AndrewFrelas/DS1302-Based-Chinese-4-in-1-Clock-Mod-ESP32-C3-Super-Mini-NTP-Time-Sync-Canada-Based/NtpClockMod.ino

// NtpClockMod - Andrew Frelas
// NTP-accurate time on the Temu 4-in-1 clock (YM-SZ010-L board) by answering the stock
// MCU's DS1302 reads. Single-file Arduino sketch. Reference: project doc ntp-clock-mod.md
//
// Target : ESP32-C3, Arduino IDE, Espressif "esp32" core 3.3.x, no external libraries
// Board  : "ESP32C3 Dev Module" (or the entry for your C3 board)
//          Tools > USB CDC On Boot: Enabled   (serial log over the C3's native USB)

// ============================================================================ CONFIGURATION

#define FW_VERSION              "01.05.01"

// ---- Wi-Fi (hardcoded; everything else is settable in the web UI and stored in NVS)
#define WIFI_SSID               "your-ssid"
#define WIFI_PASSWORD           "your-password"
#define DEVICE_HOSTNAME         "ntpclock"          // web UI: http://ntpclock.local/

// Reconnect policy: the device retries for as long as it is powered, forever.
#define WIFI_RETRY_MIN_MS       5000UL              // first retry delay after a drop
#define WIFI_RETRY_MAX_MS       60000UL             // retry delay ceiling
#define WIFI_RADIO_RESET_TRIES  12                  // failed tries before the radio is restarted

// Transmit power. Every converging report on the C3 SuperMini running hot points at the radio,
// not the core: a no-WiFi build stays cool, cutting TX power fixed it outright for one user,
// and a thermal camera showed 60 C -> 40 C from allowing modem sleep. Underclocking the CPU
// was tried once and changed nothing.
//
// esp_wifi_set_max_tx_power takes 0.25 dBm units, range [8, 84] = 2 to 20 dBm, and QUANTISES:
// {set, actual} = {8,8} {20,20} {28,28} {34,34} {44,44} {52,52} {56,56} {60,60} {66,66}
// {72,72} {80,80}, i.e. 2, 5, 7, 8, 11, 13, 14, 15, 16, 18, 20 dBm. Anything between rounds
// DOWN to the next step. The Arduino enum lies twice: WIFI_POWER_21dBm actually yields 20, and
// WIFI_POWER_MINUS_1dBm (-4) is outside the legal range and is refused. Neither is offered.
//
// Default 11 dBm: a 9 dB cut from the 20 dBm default, about an eighth of the transmit power.
// TX power cannot affect DS1302 bus timing, so this is the risk-free half of the heat work.
// Must be re-applied after every STA start - a radio reset puts it back to the default.
#define WIFI_TX_DBM_DEFAULT     11

// Modem sleep. This is the bigger lever by the one measurement anyone has taken, but it is
// also the one that could touch bus timing, so it stays off by default. WIFI_PS_MIN_MODEM
// parks the radio between DTIM beacons and leaves the CPU running, so the IRAM ISR should be
// unaffected - watch late_sclk_edge, over_budget and timeouts in Bus diagnostics to confirm
// rather than assuming. 0 = none, 1 = min modem, 2 = max modem.
#define WIFI_PS_MODE_DEFAULT    0

// ---- Optional web UI login. Empty user = no authentication (LAN only).
#define WEB_AUTH_USER           ""
#define WEB_AUTH_PASS           ""

// ---- Time defaults (first boot only; all four are editable in the web UI)
// One NTP server. No fallback servers are configured and DHCP-supplied NTP servers are
// rejected. Public pool servers: the NTP Pool asks for no more than 4-5 queries per hour,
// so use a local NTP server (router, NAS, pfSense) if you want minute-level polling.
#define DEFAULT_NTP_SERVER      "time.chu.nrc.ca"
#define DEFAULT_NTP_SERVER2     "time.nrc.ca"       // empty string = slot unused
#define DEFAULT_NTP_SERVER3     ""
#define NTP_SERVER_SLOTS        3

// Failover policy. lwIP's own multi-server handling is round-robin and STICKY: one 15 s
// timeout moves to the next slot and it stays there for good, so a single blip permanently
// demotes the primary. So lwIP is given exactly ONE server at a time in slot 0 and the policy
// lives in ntpPolicy(), where it can be reasoned about. With no other slot populated lwIP's
// internal index cannot move at all.
//
// A server that has not answered within NTP_PROBE_S of being selected is passed over. One that
// has answered is judged on ongoing silence instead, over NTP_FAILOVER_AFTER_MULT poll
// intervals floored at NTP_FAILOVER_MIN_S. While running on a fallback the primary is retried
// every NTP_RETURN_PRIMARY_S and keeps the slot if it answers.
//
// NTP_FAILOVER_DEFAULT false gives strict single-server operation. Runtime-settable either way.
#define NTP_FAILOVER_DEFAULT    true
#define NTP_FAILOVER_AFTER_MULT 2
#define NTP_FAILOVER_MIN_S      90UL
#define NTP_RETURN_PRIMARY_S    1800UL
#define NTP_PROBE_S             60UL

// How often ntpPolicy() is allowed to do any real work, in milliseconds.
//
// This exists because of a regression, and the reason is worth keeping. The policy reads
// syncCount() and lastSyncAgeUs(), and BOTH take portENTER_CRITICAL - which raises the
// interrupt threshold above BUS_INTR_LEVEL and masks the DS1302 CE ISR for their duration.
// loop() ends in delay(2), so it runs a few hundred times a second; without this gate the
// policy was taking roughly a thousand critical sections per second, every one of them a
// window where a CE rise could lose SCLK edges. The watchdog it replaced took ZERO in the
// steady state, because it bailed on a plain millis() comparison before touching anything.
//
// The visible cost was a dropped read now and then, which is a 5 on the face, and a minute
// flip arriving a poll cycle late because the read that would have carried the new minute was
// the one that got lost.
//
// One second against failover windows of 60 s and 90 s changes nothing that matters.
//
// The rule this encodes: anything called from loop() on this project must not take a lock on
// its common path. The bus ISR is the highest-value thing in the system and every critical
// section anywhere else is time it cannot run.
#define NTP_POLICY_PERIOD_MS    1000UL
#define DEFAULT_TZ              "EST5EDT,M3.2.0,M11.1.0"   // POSIX rule, America/Toronto
#define DEFAULT_SYNC_INTERVAL_S 60                  // NTP poll interval, seconds
#define DEFAULT_DST_MODE        0                   // 0 = follow zone rule, 1 = standard only, 2 = daylight only
#define DEFAULT_HOUR_FORMAT     0                   // 0 = follow the MCU, 1 = 24 hour, 2 = 12 hour

// Firmware-level hour format override. DEFAULT_HOUR_FORMAT above is only the FIRST-BOOT value:
// once anything is in NVS the compiled-in value is never read again, so it cannot pin the
// format on a unit that has already been configured. This one can - it outranks NVS and the
// web UI and is evaluated on every image build.
//   0 = no override, use the stored setting   1 = always 24 hour   2 = always 12 hour
// Worth knowing: "auto" learns from the MCU writing the hours register, and with the DS1302
// removed that only happens if the time is set with the clock's own buttons. On a fresh build
// there is usually nothing to learn from, so auto sits on 24 hour indefinitely.
#define HOUR_FORMAT_FORCE       0
#define DEFAULT_SPOOF_ENABLED   false               // off until the passive bus check passes
#define DEFAULT_BOOT_COUNTDOWN  true                // show 00:00, 03:00, 02:00, 01:00 on first arm

// Poll interval limits. 15 s is the floor enforced by SNTP (RFC 4330).
// Crystal drift. The estimator is two-point: NTP time elapsed against esp_timer elapsed from a
// baseline taken at the first sync. Its noise floor is 2 * jitter / span, so at a 300 s span
// with 10 ms of sync jitter the figure carries about +/- 67 ppm of uncertainty - larger than
// the tens of ppm it is measuring. The old gate declared it valid there, which is why a cold
// boot reported figures like 127 ppm. These are the spans at which it is worth quoting.
#define DRIFT_PPM_LIMIT         250.0f    // discard any estimate outside +/- this: bad data
#define DRIFT_VALID_SPAN_S      3600UL    // baseline before the figure is trusted
#define DRIFT_SYNC_JITTER_US    10000.0f  // assumed per-endpoint sync jitter, for the error bar
#define DRIFT_RECENT_MIN_SPAN_S 1800UL    // shortest window for the recent-rate diagnostic

#define NTP_MIN_INTERVAL_S      15UL
#define NTP_MAX_INTERVAL_S      86400UL

// How long the ESP32 keeps answering from its own clock after the last successful sync.
// Past this the bus goes high-Z and the real DS1302 answers. 0 = stop as soon as Wi-Fi drops.
#define NTP_HOLDOVER_HOURS      24

// Boot countdown step length, milliseconds (stretched to the MCU poll interval if slower).
#define BOOT_COUNTDOWN_STEP_MS  1000UL

// ---- DS1302 tap (doc section 5)
#define PIN_CE                  3   // DS1302 pin 5 - input only, rising-edge interrupt
#define PIN_SCLK                4   // DS1302 pin 7 - input only
#define PIN_IO                  5   // DS1302 pin 6 - high-Z except the data phase of a spoofed read

// ---- Bus engine
#define IO_DRIVE_STRENGTH       3   // PIN_IO drive capability 0..3 (3 = strongest: 40 mA source)
#define BUS_INTR_LEVEL          3   // CE ISR interrupt level 1..3 (3 = lowest entry latency)

// ---- DS1302 physically removed: full emulation
// 1 = the DS1302 is OUT and the ESP32 is the only thing that can answer the MCU. It then
// answers EVERY read, including before the first NTP sync, because an unanswered read
// leaves the MCU staring at a floating line. Clock registers come from NTP time (a fixed
// sane BCD image until the first sync), the control register reads back 80h, and RAM /
// trickle-charger reads are answered with zeros rather than left floating.
// 0 = the chip is fitted; behave as before and leave unspoofable reads to the real chip.
#define RTC_CHIP_REMOVED        1

// I/O drive style. 0 = push-pull (drives both levels at 3.3 V).
// 1 = open-drain: pull low only, let an external pull-up make the high. Use this with a
// 10k pull-up from the I/O line to 5 V if the MCU will not accept a 3.3 V logic high.
#define IO_OPEN_DRAIN           0

// First data bit of a read. 1 = present bit 0 as soon as the command byte completes (on the
// 8th rising edge) instead of waiting for the following falling edge. Some MCUs sample the
// first bit during the clock that ends the command, and with the datasheet timing they
// latch the command's own last bit and read every byte shifted one place left.
// Symptom of needing this: values come back as (real << 1) | 1.
#define IO_FIRST_BIT_EARLY      1

// ---- Outdoor temperature output (replaces the removed NTC bead)
// Topology measured on this board: 5V --[NTC]-- node --[~1k]-- GND, node at 2.0 V @ 21 C.
// With the bead removed the 1k holds the node at 0 V, so nothing can push 5 V back into this
// pin and no series resistor is needed. Drive the pad that reads 0 V with the bead out -
// NOT the pad that reads 5 V, which is the supply rail.
// Lower duty = lower node voltage = COLDER on the display.
#define TEMP_OUT_ENABLE         1       // 0 = never touch the pin
#define TEMP_OUT_PIN            7       // dead quiet in the GPIO scan; CE/SCLK/IO stay on 3/4/5

// PWM frequency ceiling. LEDC needs 2^bits timer ticks per period, so the ceiling is
// source_clock / 2^bits. The source is NOT the 80 MHz APB the ESP-IDF docs describe: the
// Arduino core sets LEDC_DEFAULT_CLK to LEDC_USE_XTAL_CLK on every chip with
// SOC_LEDC_SUPPORT_XTAL_CLOCK, which the C3 has, so it is the 40 MHz crystal. Real ceilings
// are 39.06 kHz at 10 bits, 78.125 kHz at 9, 156.25 kHz at 8. Above the ceiling
// ledc_timer_config() fails, ledcAttach() returns false, and the pin is never driven at all.
//
// 9 bits at 76 kHz: 0.49 C of ripple with 220 ohm and 2.2 uF, and 511 steps is still
// 0.13 C per step across the whole 0-40 C span. TEMP_RAW_MAX follows TEMP_PWM_BITS, but the
// calibration table is in raw units and must be re-measured if either changes.
#define TEMP_PWM_FREQ_HZ        76000
#define TEMP_PWM_BITS           9
#define TEMP_RAW_MAX            ((1 << TEMP_PWM_BITS) - 1)
#define TEMP_SWEEP_STEP_MS      15000UL   // dwell per step in the raw ripple sweep

// Tried in order until one attaches, so a bad frequency constant can never leave the output
// silently dead again. The achieved frequency is reported on serial and in the web UI.
#define TEMP_PWM_FALLBACKS      60000, 50000, 40000, 25000, 10000

// The RC that turns the PWM into a DC level, and the board's own lower divider leg. 220 ohm
// is the largest value that still reaches 40 C (full duty must clear 2.935 V) while keeping
// ripple at 0.5 C with 2.2 uF at 78 kHz. 470 ohm is quieter but caps the display at 37 C;
// 100 ohm reaches 40 C but leaves 1.05 C of ripple. These only affect the reported node
// voltage - change them to match what is actually fitted.
#define TEMP_SERIES_OHMS        220L
#define TEMP_NODE_LOWER_OHMS    2700L
#define TEMP_NODE_MV_MAX        (3300L * TEMP_NODE_LOWER_OHMS \
                                 / (TEMP_SERIES_OHMS + TEMP_NODE_LOWER_OHMS))
#define TEMP_HOLD_MS            180000UL  // "show 20 C" hold length, then it reverts
#define TEMP_MARCH_STEP_MS      20000UL   // default dwell; 12 s let a settling value be misread
#define TEMP_DWELL_MIN_S        5UL       // /api/temp dwell= bounds, in seconds
#define TEMP_DWELL_MAX_S        120UL
#define TEMP_HOLD_MIN_C         -50.0f    // accepted range for a requested temperature
#define TEMP_HOLD_MAX_C         60.0f

// Sub-zero encoding. The node cannot go below 0 V and 0 V reads 0 C, so the display has no
// way to show a negative number. Below zero the magnitude is sent instead: -8 C is driven as
// 8 C. With TEMP_NEG_BLINK the output alternates between that magnitude and 0 C, so a steady
// 8 means +8 and an 8 that drops to 0 and back means -8. Set to 0 for plain magnitude.
// The MCU's own ADC sampling rate is unknown: if the blink reads as an average instead of
// two distinct numbers, raise both periods until it steps cleanly.
// Whole-degree targeting. The face shows whole degrees, so aiming at a fractional value puts
// the target next to a boundary the MCU's own conversion decides, and a reading sitting at
// 21.9 can land either side of it depending on ripple and temperature. Aiming at a whole
// degree puts the target in the middle of the band that displays that number.
//   0 = send the exact value      1 = truncate toward zero: 21.9 -> 21, -3.7 -> -3
//   2 = round to nearest: 21.9 -> 22, -3.7 -> -4
// 1 and 2 are equally stable; the stability comes from landing on a whole number. 2 is never
// more than half a degree out where 1 can be a full degree, so if the face reads a degree low,
// try 2 before touching the offset. Applied BEFORE the calibration offset, so a sub-degree
// nudge is not thrown away by the rounding.
#define TEMP_WHOLE_DEGREES      1

// Sub-zero handling. The display has no minus sign and the MCU has no notion of a negative
// temperature, so a negative reading is sent as its MAGNITUDE and nothing else: -4 C shows as
// 4. A deliberate loss of information - the alternative was blinking between the magnitude and
// 0 C to hint at the sign, which encodes a meaning the hardware cannot express and reads as a
// fault rather than a minus sign.
//   0 = magnitude only, steady   1 = alternate between the magnitude and 0 C while below zero
#define TEMP_NEG_BLINK          0
#define TEMP_NEG_HIGH_MS        4000UL    // time showing the magnitude
#define TEMP_NEG_LOW_MS         2000UL    // time showing 0 C

// ---- Outdoor temperature feed (Environment and Climate Change Canada, SWOB-ML)
// Static per-station URL, no API key. CWWB = Burlington Pier (WMO 71437), the station ECCC's
// own Oakville page sources its current conditions from. Hourly, published about a minute past.
// Parsing: the literal "air_temp" WITH both quotes is unique in the document - the bare string
// also appears in avg_air_temp_pst1hr, max_air_temp_pst24hrs and six more. Same for "date_tm".
// Plain HTTP is UNTESTED against this host (could not be reached from the build environment).
// Leave WX_USE_HTTPS at 1 unless http:// is confirmed to return 200, not a redirect.
// TLS here is unauthenticated (no cert store on the device). The payload is public weather
// data and the worst case of a tampered reply is a wrong number on a clock face.
#define WX_ENABLE               1
#define WX_USE_HTTPS            1
#define WX_HOST                 "dd.weather.gc.ca"
#define WX_PATH_PREFIX          "/today/observations/swob-ml/latest/"
// Station file naming is not uniform: automatic stations publish as <CODE>-AUTO-swob.xml and
// staffed ones as <CODE>-MAN-swob.xml. 99 of the 871 files in the directory are MAN, so it is
// not an edge case - Pearson is CYYZ-MAN and Hamilton is CYHM-MAN, while Burlington Pier,
// Toronto City and Billy Bishop are all AUTO.
//
// A bare code probes AUTO then MAN with a HEAD request and caches the winner, so the normal
// path stays a single GET. A code containing "-" is taken verbatim as a full stem and never
// probed. A 404 retries the other suffix and re-caches only on a 200, so a station that
// changes category fixes itself and a transient outage cannot corrupt the cache.
#define WX_PATH_SUFFIX          "-AUTO-swob.xml"
#define WX_PATH_SUFFIX_ALT      "-MAN-swob.xml"
#define WX_PROBE_TIMEOUT_MS     8000
#define WX_STATION_DEFAULT      "CWWB"
#define WX_FETCH_INTERVAL_S     600UL     // observation is hourly; this just recovers misses
#define WX_RETRY_S              120UL     // after a failed attempt
#define WX_MAX_AGE_S            7200UL    // reject a reading whose date_tm is older than this
#define WX_TIMEOUT_MS           12000
#define WX_MAX_BYTES            32768UL   // hard cap on bytes scanned from one response
#define WX_MIN_LARGEST_BLOCK    50000UL   // skip the fetch below this; TLS needs contiguous heap

// Longest time the ISR busy-waits on one transfer. The length is projected from the
// command-byte clock rate; transfers projected past this are not answered or observed.
// Must stay far below the 300 ms interrupt watchdog.
#define BUS_TXN_BUDGET_US       40000UL

// Abort a transfer if CE stays high with no SCLK rising edge for this long.
#define BUS_EDGE_TIMEOUT_US     20000UL

// Bit-slip guard. SCLK's GPIO edge-status latch is cleared when each transfer ends; if it
// is already set when the CE ISR starts, SCLK rose before the ISR could watch it, so that
// transfer is observed but never answered. Set 0 only if SCLK is shared with another
// device that clocks it while CE is low (the passive check reports this).
#define BUS_SLIP_GUARD          1

// CE rises closer together than this count as one polling cycle.
#define POLL_GROUP_GAP_US       50000UL

// ============================================================================ END CONFIGURATION

#include <Arduino.h>
#include <ESPmDNS.h>
#include <HTTPClient.h>
#include <Preferences.h>
#include <WebServer.h>
#include <WiFi.h>
#include <WiFiClientSecure.h>

#include <algorithm>
#include <cmath>
#include <cstdarg>
#include <cstdint>
#include <cstdio>
#include <cstdlib>
#include <cstring>
#include <ctime>
#include <sys/time.h>

#include "driver/gpio.h"
#include "esp_attr.h"
#include "esp_intr_alloc.h"
#include "esp_sntp.h"
#include "esp_heap_caps.h"
#include "esp_system.h"
#include "esp_timer.h"
#include "esp_wifi.h"
#include "freertos/FreeRTOS.h"
#include "freertos/semphr.h"
#include "soc/gpio_reg.h"

// ================================================================ PURE LOGIC BEGIN
// Hardware-independent code. test/host_test.cpp extracts this region and runs it on a PC
// against a simulated MCU and DS1302.

#define DS_INLINE inline __attribute__((always_inline))

namespace ds1302 {

// Register indexes in the clock image (= burst order).
enum : uint8_t { REG_SEC = 0, REG_MIN, REG_HOUR, REG_DATE, REG_MONTH, REG_DAY, REG_YEAR, REG_CTRL };

// ---- Command byte (shifted LSB first): bit7 = 1, bit6 RAM/clock, bits5..1 address, bit0 read
DS_INLINE bool    cmdValid(uint8_t c)  { return (c & 0x80) != 0; }
DS_INLINE bool    cmdIsRead(uint8_t c) { return (c & 0x01) != 0; }
DS_INLINE bool    cmdIsRam(uint8_t c)  { return (c & 0x40) != 0; }
DS_INLINE uint8_t cmdAddr(uint8_t c)   { return (uint8_t)((c >> 1) & 0x1F); }
DS_INLINE bool    cmdIsBurst(uint8_t c){ return cmdAddr(c) == 0x1F; }

// Data bytes that follow a command: 1, or 8 for clock burst, 31 for RAM burst.
DS_INLINE uint8_t cmdDataBytes(uint8_t c) {
  if (!cmdIsBurst(c)) return 1;
  return cmdIsRam(c) ? 31 : 8;
}

// Reads the ESP32 answers: 81h..8Dh (seconds..year) and BFh (clock burst).
// 8Fh control, 91h trickle charger and all RAM reads stay with the real chip.
DS_INLINE bool cmdIsSpoofable(uint8_t c) {
  if ((c & 0xC1) != 0x81) return false;          // valid + clock space + read
  const uint8_t a = cmdAddr(c);
  return a <= REG_YEAR || a == 0x1F;
}

// ---- BCD
DS_INLINE uint8_t toBcd(uint8_t v)   { return (uint8_t)(((v / 10) << 4) | (v % 10)); }
DS_INLINE uint8_t fromBcd(uint8_t b) { return (uint8_t)(((b >> 4) * 10) + (b & 0x0F)); }
DS_INLINE bool    isBcd(uint8_t b)   { return (b & 0x0F) <= 9 && (b >> 4) <= 9; }

// ---- Hours register. bit7: 1 = 12 h mode (bit5 = PM, bits4..0 = 1..12), 0 = 24 h (bits5..0).
enum class HourMode : uint8_t { H24 = 0, H12 = 1 };

inline uint8_t encodeHour(int hour24, HourMode mode) {
  if (mode == HourMode::H24) return toBcd((uint8_t)hour24);
  int h12 = hour24 % 12;
  if (h12 == 0) h12 = 12;
  return (uint8_t)(0x80 | (hour24 >= 12 ? 0x20 : 0x00) | toBcd((uint8_t)h12));
}

// Returns 0..23, or -1 if the byte is not a legal hours value. (Called from the ISR.)
DS_INLINE int decodeHour(uint8_t reg) {
  if (reg & 0x80) {
    const uint8_t v = reg & 0x1F;
    if (!isBcd(v)) return -1;
    const int h = fromBcd(v);
    if (h < 1 || h > 12) return -1;
    return (h % 12) + ((reg & 0x20) ? 12 : 0);
  }
  const uint8_t v = reg & 0x3F;
  if (!isBcd(v)) return -1;
  const int h = fromBcd(v);
  return h <= 23 ? h : -1;
}

// ---- Clock image from broken-down local time. Control byte is left 0; the engine
// never drives it (burst byte 7 is released so the real chip's WP bit is read).
inline void buildImage(const std::tm& t, HourMode mode, uint8_t reg[8]) {
  reg[REG_SEC]   = toBcd((uint8_t)(t.tm_sec > 59 ? 59 : t.tm_sec));   // CH = 0; leap second clamps
  reg[REG_MIN]   = toBcd((uint8_t)t.tm_min);
  reg[REG_HOUR]  = encodeHour(t.tm_hour, mode);
  reg[REG_DATE]  = toBcd((uint8_t)t.tm_mday);
  reg[REG_MONTH] = toBcd((uint8_t)(t.tm_mon + 1));
  reg[REG_DAY]   = (uint8_t)(t.tm_wday + 1);                            // 1..7, Sunday = 1
  reg[REG_YEAR]  = toBcd((uint8_t)(t.tm_year % 100));
  reg[REG_CTRL]  = 0x00;
}

// True if the seven clock bytes are plausible BCD time.
inline bool imageLooksValid(const uint8_t reg[7]) {
  const uint8_t sec = reg[REG_SEC] & 0x7F;
  if (!isBcd(sec) || fromBcd(sec) > 59) return false;
  if (!isBcd(reg[REG_MIN]) || fromBcd(reg[REG_MIN]) > 59) return false;
  if (decodeHour(reg[REG_HOUR]) < 0) return false;
  if (!isBcd(reg[REG_DATE]) || fromBcd(reg[REG_DATE]) < 1 || fromBcd(reg[REG_DATE]) > 31) return false;
  if (!isBcd(reg[REG_MONTH]) || fromBcd(reg[REG_MONTH]) < 1 || fromBcd(reg[REG_MONTH]) > 12) return false;
  if (reg[REG_DAY] < 1 || reg[REG_DAY] > 7) return false;
  return isBcd(reg[REG_YEAR]);
}

// "13:05:09 2026-09-11 d6 24h" (+ " CH" if the clock-halt bit is set)
inline void formatImage(const uint8_t reg[7], char* buf, size_t n) {
  const int hour = decodeHour(reg[REG_HOUR]);
  std::snprintf(buf, n, "%02d:%02X:%02X 20%02X-%02X-%02X d%u %s%s",
                hour, reg[REG_MIN], reg[REG_SEC] & 0x7F, reg[REG_YEAR], reg[REG_MONTH],
                reg[REG_DATE], reg[REG_DAY], (reg[REG_HOUR] & 0x80) ? "12h" : "24h",
                (reg[REG_SEC] & 0x80) ? " CH" : "");
}

// "0xBF read clock burst", "0x8E write control", "0xC3 read RAM 1", "0x40 invalid (bit7=0)"
inline void describeCmd(uint8_t c, char* buf, size_t n) {
  if (!cmdValid(c)) { std::snprintf(buf, n, "0x%02X invalid (bit7=0)", c); return; }
  const char* rw = cmdIsRead(c) ? "read" : "write";
  const uint8_t a = cmdAddr(c);
  if (cmdIsRam(c)) {
    if (a == 0x1F) std::snprintf(buf, n, "0x%02X %s RAM burst", c, rw);
    else           std::snprintf(buf, n, "0x%02X %s RAM %u", c, rw, a);
    return;
  }
  static const char* const names[] = { "seconds", "minutes", "hours", "date", "month",
                                       "day", "year", "control", "trickle" };
  if (a == 0x1F)      std::snprintf(buf, n, "0x%02X %s clock burst", c, rw);
  else if (a <= 8)    std::snprintf(buf, n, "0x%02X %s %s", c, rw, names[a]);
  else                std::snprintf(buf, n, "0x%02X %s clock reg %u (undefined)", c, rw, a);
}

}  // namespace ds1302

namespace ds1302 {

enum : uint16_t {
  TF_CE_GLITCH  = 1u << 0,   // CE already low when the ISR ran
  TF_MISALIGNED = 1u << 1,   // SCLK high at entry: ISR ran late (or MCU broke tCC)
  TF_CMD        = 1u << 2,   // all 8 command bits received
  TF_INVALID    = 1u << 3,   // command bit7 = 0
  TF_READ       = 1u << 4,
  TF_BURST      = 1u << 5,
  TF_RAM        = 1u << 6,
  TF_SPOOFED    = 1u << 7,   // ESP32 answered the data phase
  TF_TOO_SLOW   = 1u << 8,   // projected length over the ISR budget: not touched
  TF_LONG       = 1u << 9,   // RAM burst (31 bytes): not touched
  TF_TIMEOUT    = 1u << 10,  // aborted mid-transaction (edge timeout / budget)
  TF_COMPLETE   = 1u << 11,  // every expected data bit was clocked
  TF_LATE_EDGE  = 1u << 12,  // SCLK rose before the ISR started: observed, never answered
};

struct TxnRecord {
  int64_t  t0Us;       // ISR entry (esp_timer time)
  uint32_t durUs;      // ISR entry -> exit
  uint32_t spanUs;     // first -> last SCLK rising edge
  uint16_t flags;
  uint16_t rises;      // SCLK rising edges seen
  uint16_t dataBits;   // data bits presented (read) / latched (write)
  uint8_t  cmd;
  uint8_t  data[8];    // passive read: real chip bytes; write: MCU bytes; spoof: bytes sent
};

struct BusPins { uint32_t ce, sclk, io; };   // bit masks within GPIO_IN_REG

class BusMachine {
 public:
  static constexpr uint8_t A_DRIVE   = 0x01;  // enable output at level A_HIGH ? 1 : 0
  static constexpr uint8_t A_HIGH    = 0x02;
  static constexpr uint8_t A_RELEASE = 0x04;  // output off (high-Z)
  static constexpr uint8_t A_DONE    = 0x08;  // stop sampling, leave the ISR

  // Call once with the first sample taken in the ISR. `img` = 8-byte clock image.
  // lateEdge = SCLK rose between the previous transfer and this ISR (possible bit slip).
  DS_INLINE uint8_t begin(const BusPins& pins, uint32_t in, int64_t t0Us, const uint8_t* img,
                          const uint8_t* ram, bool armed, uint32_t budgetUs,
                          uint32_t edgeTimeoutUs, bool lateEdge) {
    p_ = pins;
    ram_ = ram;
    t0_ = t0Us; tFirst_ = t0Us; tLast_ = t0Us;
    budget_ = budgetUs; edgeTimeout_ = edgeTimeoutUs;
    armed_ = armed;
    for (uint8_t i = 0; i < 8; ++i) { img_[i] = img[i]; rec_.data[i] = 0; }
    rec_.t0Us = t0Us; rec_.durUs = 0; rec_.spanUs = 0;
    rec_.flags = 0; rec_.rises = 0; rec_.dataBits = 0; rec_.cmd = 0;
    phase_ = PH_CMD; bits_ = 0; cmd_ = 0; nBytes_ = 0;
    outIdx_ = 0; capBits_ = 0; wIdx_ = 0; srcByte_ = 0;
    spoof_ = false; burst_ = false; driving_ = false;
    prev_ = in;
    lowIo_ = in & p_.io;
    if (lateEdge)       { rec_.flags |= TF_LATE_EDGE;  armed_ = false; }
    if (!(in & p_.ce))  { rec_.flags |= TF_CE_GLITCH;  return A_DONE; }
    if (in & p_.sclk)   { rec_.flags |= TF_MISALIGNED; return A_DONE; }
    return 0;
  }

  // True if this sample is an SCLK rising edge (caller timestamps those only).
  DS_INLINE bool isRise(uint32_t in) const { return ((in ^ prev_) & in & p_.sclk) != 0; }

  // Feed one GPIO sample. `nowUs` is only read on SCLK rising edges.
  DS_INLINE uint8_t step(uint32_t in, int64_t nowUs) {
    if (!(in & p_.ce)) return endOfTransfer();
    if (!((in ^ prev_) & p_.sclk)) {                 // no clock edge
      if (!(in & p_.sclk)) lowIo_ = in & p_.io;
      return 0;
    }
    prev_ = in;
    if (in & p_.sclk) return onRise(in, nowUs);
    lowIo_ = in & p_.io;
    return onFall();
  }

  // Call periodically from the sampling loop.
  DS_INLINE uint8_t checkTimeout(int64_t nowUs) {
    const int64_t ref = rec_.rises ? tLast_ : t0_;
    if ((nowUs - t0_) > (int64_t)budget_ || (nowUs - ref) > (int64_t)edgeTimeout_) {
      rec_.flags |= TF_TIMEOUT;
      driving_ = false;
      return A_DONE | A_RELEASE;
    }
    return 0;
  }

  DS_INLINE const TxnRecord& finish(int64_t tEndUs) {
    rec_.durUs = (uint32_t)(tEndUs - t0_);
    rec_.spanUs = (uint32_t)(tLast_ - tFirst_);
    if (phase_ == PH_READ) {
      rec_.dataBits = spoof_ ? outIdx_ : capBits_;
      if (outIdx_ >= 8u * nBytes_) rec_.flags |= TF_COMPLETE;
    } else if (phase_ == PH_WRITE) {
      rec_.dataBits = wIdx_;
      if (wIdx_ >= 8u * nBytes_) rec_.flags |= TF_COMPLETE;
    }
    return rec_;
  }

  DS_INLINE bool driving() const { return driving_; }

 private:
  enum : uint8_t { PH_CMD, PH_READ, PH_WRITE };

  DS_INLINE uint8_t onRise(uint32_t in, int64_t nowUs) {
    if (rec_.rises == 0) tFirst_ = nowUs;
    tLast_ = nowUs;
    ++rec_.rises;

    if (phase_ == PH_CMD) {
      if (in & p_.io) cmd_ |= (uint8_t)(1u << bits_);
      if (++bits_ == 8) return decide();
      return 0;
    }
    if (phase_ == PH_READ) {
      // Passive: the bit the chip presented during the low phase that just ended.
      if (!spoof_ && outIdx_ > capBits_ && outIdx_ <= 64) capture(outIdx_);
      return 0;
    }
    // PH_WRITE: MCU data is latched on the rising edge, like the chip does.
    if (wIdx_ < 8u * nBytes_) {
      if (in & p_.io) rec_.data[wIdx_ >> 3] |= (uint8_t)(1u << (wIdx_ & 7));
      ++wIdx_;
    }
    return 0;
  }

  DS_INLINE uint8_t onFall() {
    if (phase_ != PH_READ) return 0;
    const uint16_t n = outIdx_++;
    if (!spoof_) return 0;
    if (burst_) {
      if (ramBurst_) return drive(0);                // RAM burst: zeros, never floating
      if (n < 56) return drive((img_[n >> 3] >> (n & 7)) & 1u);
#if RTC_CHIP_REMOVED
      if (n < 64) return drive((img_[7] >> (n & 7)) & 1u);   // byte 7 (WP): emulate it too
#endif
      return release();                              // byte 7 (WP) and beyond: real chip
    }
    return drive((outByte_ >> (n & 7)) & 1u);        // single read: repeat the byte
  }

  DS_INLINE uint8_t decide() {
    rec_.cmd = cmd_;
    rec_.flags |= TF_CMD;
    if (!cmdValid(cmd_)) { rec_.flags |= TF_INVALID; return A_DONE; }
    const bool rd = cmdIsRead(cmd_);
    burst_ = cmdIsBurst(cmd_);
    if (rd) rec_.flags |= TF_READ;
    if (burst_) rec_.flags |= TF_BURST;
    if (cmdIsRam(cmd_)) rec_.flags |= TF_RAM;
    nBytes_ = cmdDataBytes(cmd_);
    if (nBytes_ > 8) { rec_.flags |= TF_LONG; return A_DONE; }

    // Project the remaining length from the command-phase clock rate.
    const uint32_t period  = (uint32_t)(tLast_ - tFirst_) / 7u;
    const uint32_t elapsed = (uint32_t)(tLast_ - t0_);
    if (elapsed + period * (8u * nBytes_ + 2u) > budget_) { rec_.flags |= TF_TOO_SLOW; return A_DONE; }

    phase_ = rd ? PH_READ : PH_WRITE;
    ramBurst_ = burst_ && cmdIsRam(cmd_);
#if RTC_CHIP_REMOVED
    spoof_ = rd;                 // nothing else is on the bus: every read must be answered
#else
    spoof_ = rd && armed_ && cmdIsSpoofable(cmd_);
#endif
    if (spoof_) {
      rec_.flags |= TF_SPOOFED;
      const uint8_t a = cmdAddr(cmd_);
      srcByte_ = burst_ ? 0 : a;
      // Single read: clock space 0..7 comes from the image, anything else answers zeros.
      outByte_ = cmdIsRam(cmd_) ? ((ram_ && a < 31) ? ram_[a] : 0x00)
                                : ((a <= 7) ? img_[a] : 0x00);
      if (burst_) { for (uint8_t i = 0; i < 7; ++i) rec_.data[i] = ramBurst_ ? 0 : img_[i]; }
      else        { rec_.data[0] = outByte_; }
#if IO_FIRST_BIT_EARLY
      // Present bit 0 now; the falling edges below carry bits 1..7.
      outIdx_ = 1;
      return drive(burst_ ? ((ramBurst_ ? 0u : (uint32_t)img_[0]) & 1u)
                          : ((uint32_t)outByte_ & 1u));
#endif
    }
    return 0;
  }

  DS_INLINE uint8_t endOfTransfer() {
    // Last read bit may never get a following rising edge (MCU samples, then drops CE).
    if (phase_ == PH_READ && !spoof_ && outIdx_ > capBits_ && outIdx_ <= 64) capture(outIdx_);
    const uint8_t a = A_DONE | (driving_ ? A_RELEASE : 0);
    driving_ = false;
    return a;
  }

  DS_INLINE void capture(uint16_t presented) {
    const uint16_t idx = (uint16_t)(presented - 1);
    if (lowIo_) rec_.data[idx >> 3] |= (uint8_t)(1u << (idx & 7));
    capBits_ = presented;
  }

  DS_INLINE uint8_t drive(uint32_t level) { driving_ = true; return (uint8_t)(A_DRIVE | (level ? A_HIGH : 0)); }
  DS_INLINE uint8_t release() {
    if (!driving_) return 0;
    driving_ = false;
    return A_RELEASE;
  }

  BusPins   p_{};
  TxnRecord rec_{};
  int64_t   t0_ = 0, tFirst_ = 0, tLast_ = 0;
  uint32_t  budget_ = 0, edgeTimeout_ = 0;
  uint32_t  prev_ = 0, lowIo_ = 0;
  uint16_t  outIdx_ = 0, capBits_ = 0, wIdx_ = 0;
  uint8_t   img_[8]{};
  uint8_t   phase_ = PH_CMD, bits_ = 0, cmd_ = 0, nBytes_ = 0, srcByte_ = 0;
  bool      armed_ = false, spoof_ = false, burst_ = false, driving_ = false;
  uint8_t   outByte_ = 0;          // byte repeated for a single-register read
  const uint8_t* ram_ = nullptr;   // emulated DS1302 RAM, 31 bytes
  bool      ramBurst_ = false;     // RAM burst: answered with zeros
};

}  // namespace ds1302

// ---------------------------------------------------------------- POSIX TZ rule handling
//
// POSIX form: stdoffset[dst[offset][,start[/time],end[/time]]]
// Offsets are the value added to local time to get UTC, so North America is positive.
// A name is either three or more letters or a quoted form such as <+0530> or <-07>.
//
// DST mode 1 strips the daylight half of the rule (standard time all year); mode 2 keeps
// the daylight offset all year (what a province that abolishes the change would use).

namespace tzrule {

struct Parts {
  char stdName[16];
  char dstName[16];
  long stdOffset;     // seconds
  long dstOffset;     // seconds
  bool hasDst;
};

inline const char* parseName(const char* s, char* out, size_t n) {
  size_t len = 0;
  if (*s == '<') {
    ++s;
    while (*s && *s != '>' && len + 1 < n) {
      const char c = *s;
      const bool ok = (c >= '0' && c <= '9') || (c >= 'A' && c <= 'Z') || (c >= 'a' && c <= 'z') || c == '+' || c == '-';
      if (!ok) return nullptr;
      out[len++] = *s++;
    }
    if (*s != '>') return nullptr;
    ++s;
  } else {
    while (((*s >= 'A' && *s <= 'Z') || (*s >= 'a' && *s <= 'z')) && len + 1 < n) out[len++] = *s++;
  }
  if (len < 1) return nullptr;
  out[len] = '\0';
  return s;
}

// Offsets: [+|-]hh[:mm[:ss]]
inline const char* parseOffset(const char* s, long& secs, bool& present) {
  present = false;
  int sign = 1;
  if (*s == '+') { ++s; }
  else if (*s == '-') { sign = -1; ++s; }
  if (*s < '0' || *s > '9') return s;               // no offset here
  long v[3] = { 0, 0, 0 };
  for (int field = 0; field < 3; ++field) {
    long acc = 0;
    int digits = 0;
    while (*s >= '0' && *s <= '9' && digits < 3) { acc = acc * 10 + (*s++ - '0'); ++digits; }
    if (digits == 0) return nullptr;
    v[field] = acc;
    if (*s != ':') break;
    ++s;
  }
  if (v[0] > 24 || v[1] > 59 || v[2] > 59) return nullptr;
  secs = sign * (v[0] * 3600 + v[1] * 60 + v[2]);
  present = true;
  return s;
}

inline bool parse(const char* tz, Parts& p) {
  if (!tz || !*tz) return false;
  std::memset(&p, 0, sizeof p);
  const char* s = parseName(tz, p.stdName, sizeof p.stdName);
  if (!s) return false;
  bool present = false;
  s = parseOffset(s, p.stdOffset, present);
  if (!s || !present) return false;
  if (*s == '\0' || *s == ',') return true;         // no daylight half
  s = parseName(s, p.dstName, sizeof p.dstName);
  if (!s) return false;
  p.hasDst = true;
  p.dstOffset = p.stdOffset - 3600;                 // POSIX default: one hour ahead
  s = parseOffset(s, p.dstOffset, present);
  return s != nullptr;
}

inline void formatOffset(long secs, char* out, size_t n) {
  const long a = secs < 0 ? -secs : secs;
  const int h = (int)(a / 3600), m = (int)((a % 3600) / 60), sec = (int)(a % 60);
  const char* sign = secs < 0 ? "-" : "";
  if (sec) std::snprintf(out, n, "%s%d:%02d:%02d", sign, h, m, sec);
  else if (m) std::snprintf(out, n, "%s%d:%02d", sign, h, m);
  else std::snprintf(out, n, "%s%d", sign, h);
}

inline void formatName(const char* name, char* out, size_t n) {
  bool plain = std::strlen(name) >= 3;
  for (const char* c = name; *c && plain; ++c)
    if (!((*c >= 'A' && *c <= 'Z') || (*c >= 'a' && *c <= 'z'))) plain = false;
  if (plain) std::snprintf(out, n, "%s", name);
  else std::snprintf(out, n, "<%s>", name);
}

// mode 0 = rule unchanged, 1 = standard offset all year, 2 = daylight offset all year.
// Returns false and copies the input unchanged when the rule cannot be parsed.
inline bool applyMode(const char* tz, uint8_t mode, char* out, size_t n) {
  if (n == 0) return false;
  const char* src = tz ? tz : "";
  size_t i = 0;
  for (; src[i] && i + 1 < n; ++i) out[i] = src[i];
  out[i] = '\0';
  if (mode == 0) return true;
  Parts p;
  if (!parse(tz, p)) return false;
  const bool wantDst = (mode == 2) && p.hasDst;
  char name[20], off[16];
  formatName(wantDst ? p.dstName : p.stdName, name, sizeof name);
  formatOffset(wantDst ? p.dstOffset : p.stdOffset, off, sizeof off);
  std::snprintf(out, n, "%s%s", name, off);
  return true;
}

// "follows the zone rule", "standard time all year", "daylight time all year"
inline const char* modeName(uint8_t mode) {
  if (mode == 1) return "standard time all year";
  if (mode == 2) return "daylight time all year";
  return "follows the zone rule";
}

}  // namespace tzrule

// ================================================================ PURE LOGIC END

struct BusCounters {
  uint32_t ceRises;       // CE rising-edge interrupts
  uint32_t glitches;      // CE already low when the ISR ran
  uint32_t misaligned;    // SCLK high at ISR entry
  uint32_t lateEdge;      // SCLK rose before the ISR started (not answered)
  uint32_t invalid;       // command bit7 = 0
  uint32_t singleReads;   // valid read commands, one register
  uint32_t burstReads;    // valid read commands, burst
  uint32_t writes;        // valid write commands
  uint32_t spoofed;       // reads answered by the ESP32
  uint32_t passReads;     // complete clock reads answered by the real chip (captured)
  uint32_t tooSlow;       // skipped: projected length over the ISR budget
  uint32_t longTxn;       // skipped: RAM burst
  uint32_t timeouts;      // aborted mid-transaction
  uint32_t incomplete;    // CE dropped before all data bits were clocked
  uint32_t spanUsSum;     // sum of first->last SCLK rising edge spans
  uint32_t spanPeriods;   // sum of (rising edges - 1)
};

struct BusSnapshot {
  BusCounters c;
  ds1302::TxnRecord last;       // last transaction with a full command byte
  ds1302::TxnRecord lastRead;
  ds1302::TxnRecord lastWrite;
  uint8_t  real[7];             // real DS1302 clock bytes captured from passive reads
  uint8_t  realMask;            // bit n set = real[n] captured
  int64_t  realUs;              // esp_timer time of the latest capture
  int64_t  lastCeUs;            // esp_timer time of the latest CE rise
  uint32_t pollGapUs;           // latest gap between polling cycles
  int8_t   learnedHour;         // -1 unknown, 0 = MCU uses 24 h, 1 = MCU uses 12 h
  uint32_t cmdSeen[8];          // 256-bit set of command bytes decoded
};

namespace bus {

// Configure pins and install the ISR. Returns false if the ISR could not be installed.
bool begin();

// True once the CE interrupt is live.
bool isrInstalled();

// True if the GPIO ISR service was installed IRAM-safe by this module.
bool isrIramSafe();

// Hour format the MCU was seen using: -1 unknown, 0 = 24 h, 1 = 12 h.
int8_t learnedHour();

// Latest gap between polling cycles, microseconds (0 = not seen yet).
uint32_t pollGapUs();

// Hand a new 8-byte clock image to the ISR. armed = ISR may answer clock reads.
void setImage(const uint8_t reg[8], bool armed);

// Consistent copy of all diagnostics.
void snapshot(BusSnapshot& out);

// Reset the command-seen set (used by the passive bus check).
void clearCmdSeen();

}  // namespace bus

// ---------------------------------------------------------------- implementation

namespace bus {
namespace impl {

using namespace ds1302;

struct Shared {
  volatile uint32_t seq;   // seqlock: odd while the ISR is publishing
  BusCounters c;
  TxnRecord last, lastRead, lastWrite;
  uint8_t  real[7];
  uint8_t  realMask;
  int64_t  realUs;
  int64_t  lastCeUs;
  uint32_t pollGapUs;
  int8_t   learnedHour;
  uint32_t cmdSeen[8];
};

struct ImageSlot { uint8_t reg[8]; };

Shared            s_sh;
ImageSlot         s_img[2];
volatile uint8_t  s_imgActive = 0;     // written only by setImage()
DRAM_ATTR uint8_t s_ram[31] = {0};     // emulated DS1302 scratch RAM (chip-removed mode)
volatile bool     s_armed = false;
bool              s_iramSafe = false;
bool              s_installed = false;
BusMachine        s_machine;           // single instance: the ISR is not re-entrant

DRAM_ATTR const BusPins s_pins = { 1UL << PIN_CE, 1UL << PIN_SCLK, 1UL << PIN_IO };

constexpr uint32_t IO_MASK = 1UL << PIN_IO;
constexpr uint32_t SCLK_MASK = 1UL << PIN_SCLK;

int levelFlag() {
#if BUS_INTR_LEVEL == 1
  return ESP_INTR_FLAG_LEVEL1;
#elif BUS_INTR_LEVEL == 2
  return ESP_INTR_FLAG_LEVEL2;
#else
  return ESP_INTR_FLAG_LEVEL3;
#endif
}

inline __attribute__((always_inline)) void learnHour(Shared& s, uint8_t reg) {
  if (decodeHour(reg) >= 0) s.learnedHour = (reg & 0x80) ? 1 : 0;
}

IRAM_ATTR void publish(const TxnRecord& r) {
  Shared& s = s_sh;
  s.seq = s.seq + 1;
  BusCounters& c = s.c;
  const uint16_t f = r.flags;

  ++c.ceRises;
  if (s.lastCeUs != 0 && (r.t0Us - s.lastCeUs) > (int64_t)POLL_GROUP_GAP_US)
    s.pollGapUs = (uint32_t)(r.t0Us - s.lastCeUs);
  s.lastCeUs = r.t0Us;

  if (f & TF_CE_GLITCH)  ++c.glitches;
  if (f & TF_MISALIGNED) ++c.misaligned;
  if (f & TF_LATE_EDGE)  ++c.lateEdge;
  if (f & TF_TIMEOUT)    ++c.timeouts;
  if (f & TF_TOO_SLOW)   ++c.tooSlow;
  if (f & TF_LONG)       ++c.longTxn;
  if (r.rises >= 2) { c.spanUsSum += r.spanUs; c.spanPeriods += (uint32_t)(r.rises - 1); }

  if (f & TF_CMD) {
    s.cmdSeen[r.cmd >> 5] |= 1UL << (r.cmd & 31);
    s.last = r;
    if (f & TF_INVALID) {
      ++c.invalid;
    } else {
      const bool handled = !(f & (TF_TOO_SLOW | TF_LONG | TF_TIMEOUT | TF_LATE_EDGE));
      const bool clock   = !(f & TF_RAM);
      const bool burst   = (f & TF_BURST) != 0;
      const uint8_t addr = cmdAddr(r.cmd);
      if (handled && !(f & TF_COMPLETE)) ++c.incomplete;

      // Store single-byte RAM writes. The MCU keeps its own state in the DS1302's RAM and
      // must read back what it wrote; answering zeros silently corrupts it.
      if (handled && !clock && !burst && !(f & TF_READ) && (f & TF_COMPLETE) && addr < 31)
        s_ram[addr] = r.data[0];

      if (f & TF_READ) {
        if (burst) ++c.burstReads; else ++c.singleReads;
        s.lastRead = r;
        if (f & TF_SPOOFED) {
          ++c.spoofed;
        } else if (handled && clock) {
          if (burst && r.dataBits >= 56) {              // 7 clock bytes captured
            for (uint8_t i = 0; i < 7; ++i) s.real[i] = r.data[i];
            s.realMask = 0x7F;
            s.realUs = r.t0Us;
            learnHour(s, r.data[REG_HOUR]);
            ++c.passReads;
          } else if (!burst && addr <= REG_YEAR && r.dataBits >= 8) {
            s.real[addr] = r.data[0];
            s.realMask |= (uint8_t)(1u << addr);
            s.realUs = r.t0Us;
            if (addr == REG_HOUR) learnHour(s, r.data[0]);
            ++c.passReads;
          }
        }
      } else {
        ++c.writes;
        s.lastWrite = r;
        if (handled && clock) {
          if (burst && r.dataBits >= 24) learnHour(s, r.data[REG_HOUR]);
          else if (!burst && addr == REG_HOUR && r.dataBits >= 8) learnHour(s, r.data[0]);
        }
      }
    }
  }
  s.seq = s.seq + 1;
}

// CE rising edge: follow the whole transaction by polling, then return.
IRAM_ATTR void ceRiseIsr(void*) {
  const int64_t t0 = esp_timer_get_time();
  uint32_t in = REG_READ(GPIO_IN_REG);
#if BUS_SLIP_GUARD
  const bool lateEdge = (REG_READ(GPIO_STATUS_REG) & SCLK_MASK) != 0;
#else
  const bool lateEdge = false;
#endif
  BusMachine& m = s_machine;
  uint8_t a = m.begin(s_pins, in, t0, s_img[s_imgActive].reg, s_ram, s_armed,
                      BUS_TXN_BUDGET_US, BUS_EDGE_TIMEOUT_US, lateEdge);
  bool outOn = false;
  uint32_t spins = 0;

  while (!(a & BusMachine::A_DONE)) {
    in = REG_READ(GPIO_IN_REG);
    a = m.step(in, m.isRise(in) ? esp_timer_get_time() : 0);
    if (a & BusMachine::A_DRIVE) {
      // Level first, then output enable: no glitch on the first driven bit.
#if IO_OPEN_DRAIN
      if (a & BusMachine::A_HIGH) {                  // high = let the external pull-up do it
        if (outOn) { REG_WRITE(GPIO_ENABLE_W1TC_REG, IO_MASK); outOn = false; }
      } else {
        REG_WRITE(GPIO_OUT_W1TC_REG, IO_MASK);
        if (!outOn) { REG_WRITE(GPIO_ENABLE_W1TS_REG, IO_MASK); outOn = true; }
      }
#else
      REG_WRITE((a & BusMachine::A_HIGH) ? GPIO_OUT_W1TS_REG : GPIO_OUT_W1TC_REG, IO_MASK);
      if (!outOn) { REG_WRITE(GPIO_ENABLE_W1TS_REG, IO_MASK); outOn = true; }
#endif
    } else if (a & BusMachine::A_RELEASE) {
      REG_WRITE(GPIO_ENABLE_W1TC_REG, IO_MASK);
      outOn = false;
    }
    if ((++spins & 0x3FF) == 0 && !(a & BusMachine::A_DONE))
      a |= m.checkTimeout(esp_timer_get_time());
  }

  REG_WRITE(GPIO_ENABLE_W1TC_REG, IO_MASK);   // always leave the ISR high-Z
  REG_WRITE(GPIO_STATUS_W1TC_REG, SCLK_MASK); // arm the slip latch for the next transfer
  publish(m.finish(esp_timer_get_time()));
}

}  // namespace impl

using namespace impl;

bool begin() {
  s_sh.learnedHour = -1;

  // CE + SCLK: plain inputs, no pulls (the DS1302 has 40k pulldowns, the MCU drives both).
  gpio_config_t cfg = {};
  cfg.pin_bit_mask = (1ULL << PIN_CE) | (1ULL << PIN_SCLK);
  cfg.mode = GPIO_MODE_INPUT;
  cfg.pull_up_en = GPIO_PULLUP_DISABLE;
  cfg.pull_down_en = GPIO_PULLDOWN_DISABLE;
  cfg.intr_type = GPIO_INTR_DISABLE;
  if (gpio_config(&cfg) != ESP_OK) return false;

  // I/O: input always on; the ISR toggles output enable. Output latch preset low.
  gpio_set_level((gpio_num_t)PIN_IO, 0);
  cfg.pin_bit_mask = 1ULL << PIN_IO;
  cfg.mode = GPIO_MODE_INPUT_OUTPUT;
  if (gpio_config(&cfg) != ESP_OK) return false;
  REG_WRITE(GPIO_ENABLE_W1TC_REG, IO_MASK);   // high-Z
  gpio_set_drive_capability((gpio_num_t)PIN_IO, (gpio_drive_cap_t)IO_DRIVE_STRENGTH);

  const esp_err_t err = gpio_install_isr_service(ESP_INTR_FLAG_IRAM | levelFlag());
  if (err == ESP_OK) s_iramSafe = true;
  else if (err != ESP_ERR_INVALID_STATE) return false;   // INVALID_STATE: installed elsewhere

  // SCLK: rising-edge status latch only. Its interrupt stays disabled, so the GPIO ISR
  // service never dispatches it (it only sees status & enable); the CE ISR reads and
  // clears the raw bit itself.
  if (gpio_set_intr_type((gpio_num_t)PIN_SCLK, GPIO_INTR_POSEDGE) != ESP_OK) return false;
  gpio_intr_disable((gpio_num_t)PIN_SCLK);
  REG_WRITE(GPIO_STATUS_W1TC_REG, SCLK_MASK);

  if (gpio_set_intr_type((gpio_num_t)PIN_CE, GPIO_INTR_POSEDGE) != ESP_OK) return false;
  if (gpio_isr_handler_add((gpio_num_t)PIN_CE, ceRiseIsr, nullptr) != ESP_OK) return false;
  s_installed = gpio_intr_enable((gpio_num_t)PIN_CE) == ESP_OK;
  return s_installed;
}

bool isrInstalled() { return s_installed; }

bool isrIramSafe() { return s_iramSafe; }

int8_t learnedHour() { return s_sh.learnedHour; }

uint32_t pollGapUs() { return s_sh.pollGapUs; }

// Single writer (the time task). The ISR only ever reads the active slot.
void setImage(const uint8_t reg[8], bool armed) {
  if (!armed) s_armed = false;
  const uint8_t next = (uint8_t)(s_imgActive ^ 1);
  std::memcpy(s_img[next].reg, reg, 8);
  s_imgActive = next;
  if (armed) s_armed = true;
}

void snapshot(BusSnapshot& o) {
  for (;;) {
    const uint32_t seq = s_sh.seq;
    o.c = s_sh.c;
    o.last = s_sh.last;
    o.lastRead = s_sh.lastRead;
    o.lastWrite = s_sh.lastWrite;
    std::memcpy(o.real, s_sh.real, sizeof o.real);
    o.realMask = s_sh.realMask;
    o.realUs = s_sh.realUs;
    o.lastCeUs = s_sh.lastCeUs;
    o.pollGapUs = s_sh.pollGapUs;
    o.learnedHour = s_sh.learnedHour;
    std::memcpy(o.cmdSeen, s_sh.cmdSeen, sizeof o.cmdSeen);
    if (!(seq & 1) && seq == s_sh.seq) return;
  }
}

void clearCmdSeen() {
  for (uint8_t i = 0; i < 8; ++i) s_sh.cmdSeen[i] = 0;
}

}  // namespace bus

// ================================================================ SETTINGS (NVS)

enum : uint8_t { HOURFMT_AUTO = 0, HOURFMT_24 = 1, HOURFMT_12 = 2 };
enum : uint8_t { DST_AUTO = 0, DST_STANDARD = 1, DST_DAYLIGHT = 2 };

struct Settings {
  // lwIP is handed these by POINTER and keeps them for as long as it runs, so they live here,
  // at file scope, and are never moved or freed.
  char     ntpServer[64];
  char     ntpServer2[64];    // empty = slot unused
  char     ntpServer3[64];
  bool     ntpFailover;       // false = slot 0 only, never try another server
  char     tz[64];            // POSIX rule as chosen in the UI, before the DST mode is applied
  uint32_t syncIntervalS;
  uint8_t  dstMode;
  uint8_t  hourFormat;
  bool     spoofEnabled;
  bool     bootCountdown;
  char     wxStation[16];     // SWOB-ML code (CWWB) or a full stem (CYYZ-MAN)
  char     wxSuffix[16];      // cached winning suffix for a bare code
  int8_t   wifiTxDbm;         // 2..20, quantised by the radio to the steps above
  uint8_t  wifiPsMode;        // 0 none, 1 min modem, 2 max modem
};

// The transmit powers the radio can actually produce, in dBm. Anything else rounds down.
const int8_t WIFI_TX_STEPS[] = { 2, 5, 7, 8, 11, 13, 14, 15, 16, 18, 20 };
const uint8_t WIFI_TX_STEPS_N = sizeof WIFI_TX_STEPS / sizeof WIFI_TX_STEPS[0];

Settings g_settings;

namespace settings {

namespace impl {

const char* const NVS_NS = "ntpclock";

void copyStr(char* dst, size_t n, const char* src) {
  std::strncpy(dst, src, n - 1);
  dst[n - 1] = '\0';
}

bool isAlnum(char c) {
  return (c >= 'a' && c <= 'z') || (c >= 'A' && c <= 'Z') || (c >= '0' && c <= '9');
}

}  // namespace impl

// Hostname or IPv4 literal, 1..63 characters.
bool validNtpServer(const char* s) {
  const size_t n = std::strlen(s);
  if (n == 0 || n > 63) return false;
  char prev = '.';                                   // forbids a leading '.' or '-'
  for (size_t i = 0; i < n; ++i) {
    const char c = s[i];
    if (c == '.') {
      if (prev == '.' || prev == '-') return false;   // empty label or label ending in '-'
    } else if (c == '-') {
      if (prev == '.') return false;                  // label starting with '-'
    } else if (!impl::isAlnum(c)) {
      return false;
    }
    prev = c;
  }
  return prev != '.' && prev != '-';
}

// Snap a requested transmit power to a step the radio can actually produce, never upward:
// asking for 12 dBm and silently getting 11 is the radio's behaviour, so make it visible.
int8_t quantiseTxDbm(int v) {
  if (v <= WIFI_TX_STEPS[0]) return WIFI_TX_STEPS[0];
  for (uint8_t i = WIFI_TX_STEPS_N; i-- > 0; )
    if (v >= WIFI_TX_STEPS[i]) return WIFI_TX_STEPS[i];
  return WIFI_TX_STEPS[0];
}

// SWOB-ML station: a bare code (CWWB) or a full stem (CYYZ-MAN). The value is concatenated
// straight into a URL path, so the character set is deliberately ONE character wider than it
// was and no wider: '/', '.' and '%' are a path-traversal surface and stay out. Leading,
// trailing and doubled hyphens are rejected because none of them can name a real file.
bool validWxStation(const char* s) {
  const size_t n = std::strlen(s);
  if (n < 3 || n > 14) return false;
  if (s[0] == '-' || s[n - 1] == '-') return false;
  for (size_t i = 0; i < n; ++i) {
    const char c = s[i];
    if (c == '-') { if (s[i + 1] == '-') return false; continue; }
    if (!((c >= 'A' && c <= 'Z') || (c >= '0' && c <= '9'))) return false;
  }
  return true;
}

// True when the value already names a complete stem and must not be probed.
bool wxStationIsStem(const char* s) { return std::strchr(s, '-') != nullptr; }

// POSIX TZ character set, 3..63 characters, and it must parse as a rule.
bool validTz(const char* s) {
  const size_t n = std::strlen(s);
  if (n < 3 || n > 63) return false;
  if (!(impl::isAlnum(s[0]) || s[0] == '<')) return false;
  for (size_t i = 0; i < n; ++i) {
    const char c = s[i];
    if (!(impl::isAlnum(c) || std::strchr("<>+-:,./", c))) return false;
  }
  tzrule::Parts p;
  return tzrule::parse(s, p);
}

uint32_t clampInterval(uint32_t s) {
  if (s < NTP_MIN_INTERVAL_S) return NTP_MIN_INTERVAL_S;
  if (s > NTP_MAX_INTERVAL_S) return NTP_MAX_INTERVAL_S;
  return s;
}

const char* hourFormatName(uint8_t f) {
  if (f == HOURFMT_24) return "24h";
  if (f == HOURFMT_12) return "12h";
  return "auto";
}

bool parseHourFormat(const char* s, uint8_t& out) {
  if (!std::strcmp(s, "auto")) { out = HOURFMT_AUTO; return true; }
  if (!std::strcmp(s, "24h")) { out = HOURFMT_24; return true; }
  if (!std::strcmp(s, "12h")) { out = HOURFMT_12; return true; }
  return false;
}

const char* dstModeName(uint8_t m) {
  if (m == DST_STANDARD) return "standard";
  if (m == DST_DAYLIGHT) return "daylight";
  return "auto";
}

bool parseDstMode(const char* s, uint8_t& out) {
  if (!std::strcmp(s, "auto")) { out = DST_AUTO; return true; }
  if (!std::strcmp(s, "standard")) { out = DST_STANDARD; return true; }
  if (!std::strcmp(s, "daylight")) { out = DST_DAYLIGHT; return true; }
  return false;
}

// Effective POSIX rule: the stored zone rule with the DST mode applied.
void effectiveTz(char* out, size_t n) {
  tzrule::applyMode(g_settings.tz, g_settings.dstMode, out, n);
}

void load() {
  impl::copyStr(g_settings.ntpServer, sizeof g_settings.ntpServer, DEFAULT_NTP_SERVER);
  impl::copyStr(g_settings.ntpServer2, sizeof g_settings.ntpServer2, DEFAULT_NTP_SERVER2);
  impl::copyStr(g_settings.ntpServer3, sizeof g_settings.ntpServer3, DEFAULT_NTP_SERVER3);
  g_settings.ntpFailover = NTP_FAILOVER_DEFAULT;
  impl::copyStr(g_settings.wxSuffix, sizeof g_settings.wxSuffix, WX_PATH_SUFFIX);
  impl::copyStr(g_settings.tz, sizeof g_settings.tz, DEFAULT_TZ);
  g_settings.syncIntervalS = DEFAULT_SYNC_INTERVAL_S;
  g_settings.dstMode = DEFAULT_DST_MODE;
  g_settings.hourFormat = DEFAULT_HOUR_FORMAT;
  g_settings.spoofEnabled = DEFAULT_SPOOF_ENABLED;
  g_settings.bootCountdown = DEFAULT_BOOT_COUNTDOWN;
  impl::copyStr(g_settings.wxStation, sizeof g_settings.wxStation, WX_STATION_DEFAULT);
  g_settings.wifiTxDbm = WIFI_TX_DBM_DEFAULT;
  g_settings.wifiPsMode = WIFI_PS_MODE_DEFAULT;

  Preferences p;
  if (!p.begin(impl::NVS_NS, false)) return;
  char buf[64];
  if (p.isKey("ntp") && p.getString("ntp", buf, sizeof buf) > 0 && validNtpServer(buf))
    impl::copyStr(g_settings.ntpServer, sizeof g_settings.ntpServer, buf);
  // getString returns 0 WITHOUT writing to buf on a read error, and buf is shared across every
  // read here, so a failure would otherwise leave the PREVIOUS key's value in place - the
  // primary's hostname, which validates fine and turns slot 1 into a duplicate of slot 0.
  // Failing over to the same dead host is worse than having no fallback. Clearing buf first
  // makes a read error indistinguishable from an empty value, which is the safe reading.
  if (p.isKey("ntp2")) {
    buf[0] = '\0'; p.getString("ntp2", buf, sizeof buf);
    if (buf[0] == '\0' || validNtpServer(buf))
      impl::copyStr(g_settings.ntpServer2, sizeof g_settings.ntpServer2, buf);
  }
  if (p.isKey("ntp3")) {
    buf[0] = '\0'; p.getString("ntp3", buf, sizeof buf);
    if (buf[0] == '\0' || validNtpServer(buf))
      impl::copyStr(g_settings.ntpServer3, sizeof g_settings.ntpServer3, buf);
  }
  g_settings.ntpFailover = p.getBool("ntpfo", NTP_FAILOVER_DEFAULT);
  if (p.isKey("tz") && p.getString("tz", buf, sizeof buf) > 0 && validTz(buf))
    impl::copyStr(g_settings.tz, sizeof g_settings.tz, buf);
  g_settings.syncIntervalS = clampInterval(p.getULong("ival", DEFAULT_SYNC_INTERVAL_S));
  const uint8_t dst = p.getUChar("dst", DEFAULT_DST_MODE);
  g_settings.dstMode = dst <= DST_DAYLIGHT ? dst : (uint8_t)DST_AUTO;
  const uint8_t hf = p.getUChar("hrfmt", DEFAULT_HOUR_FORMAT);
  g_settings.hourFormat = hf <= HOURFMT_12 ? hf : (uint8_t)HOURFMT_AUTO;
  g_settings.spoofEnabled = p.getBool("spoof", DEFAULT_SPOOF_ENABLED);
  g_settings.bootCountdown = p.getBool("bootcd", DEFAULT_BOOT_COUNTDOWN);
  if (p.isKey("wxstn") && p.getString("wxstn", buf, sizeof buf) > 0 && validWxStation(buf))
    impl::copyStr(g_settings.wxStation, sizeof g_settings.wxStation, buf);
  if (p.isKey("wxsfx") && p.getString("wxsfx", buf, sizeof buf) > 0 &&
      (!std::strcmp(buf, WX_PATH_SUFFIX) || !std::strcmp(buf, WX_PATH_SUFFIX_ALT)))
    impl::copyStr(g_settings.wxSuffix, sizeof g_settings.wxSuffix, buf);
  g_settings.wifiTxDbm = quantiseTxDbm(p.getChar("wtx", WIFI_TX_DBM_DEFAULT));
  const uint8_t ps = p.getUChar("wps", WIFI_PS_MODE_DEFAULT);
  g_settings.wifiPsMode = ps <= 2 ? ps : (uint8_t)0;
  p.end();
}

bool save() {
  Preferences p;
  if (!p.begin(impl::NVS_NS, false)) return false;
  bool ok = p.putString("ntp", g_settings.ntpServer) > 0;
  // Preferences::putString returns size_t: strlen(value) on success and 0 on FAILURE, so an
  // empty value and a failed write return the same thing. The only sound test is against the
  // length that was asked for.
  ok = (p.putString("ntp2", g_settings.ntpServer2) == std::strlen(g_settings.ntpServer2)) && ok;
  ok = (p.putString("ntp3", g_settings.ntpServer3) == std::strlen(g_settings.ntpServer3)) && ok;
  ok = p.putBool("ntpfo", g_settings.ntpFailover) > 0 && ok;
  ok = p.putString("tz", g_settings.tz) > 0 && ok;
  ok = p.putULong("ival", g_settings.syncIntervalS) > 0 && ok;
  ok = p.putUChar("dst", g_settings.dstMode) > 0 && ok;
  ok = p.putUChar("hrfmt", g_settings.hourFormat) > 0 && ok;
  ok = p.putBool("spoof", g_settings.spoofEnabled) > 0 && ok;
  ok = p.putBool("bootcd", g_settings.bootCountdown) > 0 && ok;
  ok = p.putString("wxstn", g_settings.wxStation) > 0 && ok;
  ok = p.putString("wxsfx", g_settings.wxSuffix) > 0 && ok;
  ok = p.putChar("wtx", g_settings.wifiTxDbm) > 0 && ok;
  ok = p.putUChar("wps", g_settings.wifiPsMode) > 0 && ok;
  p.end();
  return ok;
}

}  // namespace settings

// ================================================================ TIMEKEEPING (SNTP + TZ)

namespace timekeeping {

namespace impl {

char              server_[64];          // lwIP keeps this pointer, so it must stay valid
char              activeTz_[64];        // effective POSIX rule in use
SemaphoreHandle_t tzMutex_ = nullptr;
portMUX_TYPE      mux_ = portMUX_INITIALIZER_UNLOCKED;
time_t            lastSyncEpoch_ = 0;
int64_t           lastSyncUs_ = -1;
int64_t           baseNtpUs_ = 0;       // NTP time at the drift baseline sync, microseconds
int64_t           baseEspUs_ = 0;       // esp_timer at that same sync
bool              haveBase_ = false;
// Mid-point sample. The long baseline gives the low-noise figure; a second sample taken part
// way along gives a recent-window rate, which is what moves when the board's temperature does.
// Without it a rate shift takes as long to show as the whole baseline, because a two-point
// estimate from a fixed origin averages everything since boot.
int64_t           midNtpUs_ = 0;
int64_t           midEspUs_ = 0;
bool              haveMid_ = false;
float             recentPpm_ = 0.0f;
uint32_t          recentSpanS_ = 0;
uint8_t           activeSlot_ = 0;      // which configured server is currently installed
uint32_t          slotSinceMs_ = 0;     // millis() when it was installed
uint32_t          slotSyncCount_ = 0;   // syncCount_ then; proves THIS server replied
float             driftPpm_ = 0.0f;     // crystal fast(+) / slow(-) versus NTP
uint32_t          driftSpanS_ = 0;      // baseline length the figure is measured over
uint32_t          syncCount_ = 0;
uint32_t          intervalS_ = DEFAULT_SYNC_INTERVAL_S;

constexpr time_t PLAUSIBLE_EPOCH = 1735689600;   // 2025-01-01T00:00:00Z

// Crystal drift: esp_timer measures elapsed time on the local crystal, NTP measures the real
// elapsed time. The difference over a long baseline is the crystal error.
//
// Every division below is OUTSIDE the lock, deliberately. This chip has no FPU, so each double
// operation is a libgcc call in flash costing tens of microseconds, usually cold - and
// portENTER_CRITICAL raises the interrupt threshold above BUS_INTR_LEVEL, masking the DS1302
// CE ISR for the whole window. A CE rise landing in it loses SCLK edges. Only the stores are
// protected. Reading the baselines unlocked is safe: this callback is their only writer.
void onSync(struct timeval* tv) {                // runs in the lwIP task
  const int64_t now = esp_timer_get_time();
  const int64_t ntpUs = (int64_t)tv->tv_sec * 1000000LL + (int64_t)tv->tv_usec;

  bool  haveLong = false, haveRecent = false, rollMid = false, setBase = false;
  float longPpm = 0.0f, recentPpm = 0.0f;
  uint32_t longSpan = 0, recentSpan = 0;

  if (!haveBase_) {
    setBase = true;
  } else {
    const int64_t dNtp = ntpUs - baseNtpUs_;
    const int64_t dEsp = now - baseEspUs_;
    if (dNtp > 0) {
      const float ppm = (float)((double)(dEsp - dNtp) * 1000000.0 / (double)dNtp);
      // Outside the sanity limit means a bad packet or a stepped clock, not a real rate.
      if (ppm > -DRIFT_PPM_LIMIT && ppm < DRIFT_PPM_LIMIT) {
        longPpm = ppm; longSpan = (uint32_t)(dNtp / 1000000LL); haveLong = true;
      }
    } else {
      // The baseline is ahead of this reply, so it came from a bad packet - SNTP steps the
      // clock to whatever arrives and nothing upstream range-checks it. Left alone this is
      // permanent: dNtp stays negative for the life of the boot and no figure is ever produced
      // again. Re-anchor here instead.
      setBase = true;
    }
    if (haveMid_) {
      const int64_t rNtp = ntpUs - midNtpUs_;
      const int64_t rEsp = now - midEspUs_;
      if (rNtp >= (int64_t)DRIFT_RECENT_MIN_SPAN_S * 1000000LL) {
        const float ppm = (float)((double)(rEsp - rNtp) * 1000000.0 / (double)rNtp);
        if (ppm > -DRIFT_PPM_LIMIT && ppm < DRIFT_PPM_LIMIT) {
          recentPpm = ppm; recentSpan = (uint32_t)(rNtp / 1000000LL); haveRecent = true;
        }
        rollMid = true;
      } else if (rNtp < 0) {
        rollMid = true;
      }
    } else {
      rollMid = true;
    }
  }

  portENTER_CRITICAL(&mux_);
  lastSyncEpoch_ = tv->tv_sec;
  lastSyncUs_ = now;
  ++syncCount_;
  if (setBase)    { baseNtpUs_ = ntpUs; baseEspUs_ = now; haveBase_ = true; driftSpanS_ = 0; }
  if (haveLong)   { driftPpm_ = longPpm; driftSpanS_ = longSpan; }
  if (haveRecent) { recentPpm_ = recentPpm; recentSpanS_ = recentSpan; }
  if (rollMid)    { midNtpUs_ = ntpUs; midEspUs_ = now; haveMid_ = true; }
  portEXIT_CRITICAL(&mux_);
}

}  // namespace impl

void setTz(const char* tz) {
  xSemaphoreTake(impl::tzMutex_, portMAX_DELAY);
  std::strncpy(impl::activeTz_, tz, sizeof impl::activeTz_ - 1);
  impl::activeTz_[sizeof impl::activeTz_ - 1] = '\0';
  setenv("TZ", impl::activeTz_, 1);
  tzset();
  xSemaphoreGive(impl::tzMutex_);
}

void begin(const char* ntpServer, const char* tz, uint32_t intervalS) {
  if (!impl::tzMutex_) impl::tzMutex_ = xSemaphoreCreateMutex();
  std::strncpy(impl::server_, ntpServer, sizeof impl::server_ - 1);
  impl::server_[sizeof impl::server_ - 1] = '\0';
  impl::intervalS_ = intervalS;
  setTz(tz);
}

// (Re)start SNTP: one server, no fallbacks, no DHCP-supplied servers, immediate request.
// The configured server for one of our slots, or an empty string if that slot is unused.
const char* slotServer(uint8_t i) {
  if (i == 1) return g_settings.ntpServer2;
  if (i == 2) return g_settings.ntpServer3;
  return g_settings.ntpServer;
}

bool slotUsable(uint8_t i) {
  if (i > 0 && !g_settings.ntpFailover) return false;   // failover off: only slot 0 exists
  return slotServer(i)[0] != '\0';
}

// (Re)start SNTP with exactly ONE server - whichever slot is active - in lwIP slot 0, every
// other slot cleared. lwIP's own selection is round-robin and sticky, so a single timeout on
// the primary would demote it permanently; with no other slot populated its index cannot move
// and the policy is entirely ours. The pointer lwIP keeps is always impl::server_, one buffer
// that outlives every restart, so a settings edit cannot move a string it may be resolving.
void restart() {
  if (esp_sntp_enabled()) esp_sntp_stop();
  esp_sntp_setoperatingmode(ESP_SNTP_OPMODE_POLL);
#if CONFIG_LWIP_DHCP_GET_NTP_SRV
  esp_sntp_servermode_dhcp(false);
#endif
  esp_sntp_setservername(0, impl::server_);
  for (uint8_t i = 1; i < CONFIG_LWIP_SNTP_MAX_SERVERS; ++i)
    esp_sntp_setserver(i, nullptr);                // clears address and name: no fallbacks
  sntp_set_sync_mode(SNTP_SYNC_MODE_IMMED);        // step the clock, do not slew
  sntp_set_sync_interval(impl::intervalS_ * 1000UL);
  sntp_set_time_sync_notification_cb(impl::onSync);
  esp_sntp_init();
}

// Install one of our slots as the single lwIP server.
void selectSlot(uint8_t slot) {
  if (slot >= NTP_SERVER_SLOTS) slot = 0;
  const char* name = slotServer(slot);
  if (name[0] == '\0') { slot = 0; name = slotServer(0); }
  if (name[0] == '\0') return;                     // nothing configured at all
  if (esp_sntp_enabled()) esp_sntp_stop();
  std::strncpy(impl::server_, name, sizeof impl::server_ - 1);
  impl::server_[sizeof impl::server_ - 1] = '\0';
  impl::activeSlot_ = slot;
  impl::slotSinceMs_ = millis();
  portENTER_CRITICAL(&impl::mux_);
  impl::slotSyncCount_ = impl::syncCount_;
  portEXIT_CRITICAL(&impl::mux_);
  restart();
}

uint8_t  activeSlot()    { return impl::activeSlot_; }
uint32_t slotSinceMs()   { return impl::slotSinceMs_; }
uint32_t slotSyncCount() { return impl::slotSyncCount_; }

// The next usable slot after `from`, wrapping. Returns `from` when nothing else is configured,
// so a lone-server setup degenerates into a plain restart rather than a special case.
uint8_t nextUsableSlot(uint8_t from) {
  for (uint8_t step = 1; step <= NTP_SERVER_SLOTS; ++step) {
    const uint8_t cand = (uint8_t)((from + step) % NTP_SERVER_SLOTS);
    if (slotUsable(cand)) return cand;
  }
  return from;
}

// Editing a server is an explicit statement of intent, so it re-anchors on the primary rather
// than leaving the device on a fallback it was sent to before the change.
void setServer(const char* ntpServer) {
  if (esp_sntp_enabled()) esp_sntp_stop();         // stop before the buffer changes
  std::strncpy(impl::server_, ntpServer, sizeof impl::server_ - 1);
  impl::server_[sizeof impl::server_ - 1] = '\0';
  impl::activeSlot_ = 0;
  impl::slotSinceMs_ = millis();
  portENTER_CRITICAL(&impl::mux_);
  impl::slotSyncCount_ = impl::syncCount_;
  portEXIT_CRITICAL(&impl::mux_);
  restart();
}

void setSyncInterval(uint32_t intervalS) {
  impl::intervalS_ = intervalS;
  sntp_set_sync_interval(intervalS * 1000UL);
  if (esp_sntp_enabled()) sntp_restart();          // apply now instead of after the old interval
}

// Immediate poll without changing any setting.
bool syncNow() {
  if (!esp_sntp_enabled()) { restart(); return true; }
  return sntp_restart();
}

bool localNow(std::tm& out, time_t* epoch = nullptr) {
  const time_t now = time(nullptr);
  if (epoch) *epoch = now;
  xSemaphoreTake(impl::tzMutex_, portMAX_DELAY);
  localtime_r(&now, &out);
  xSemaphoreGive(impl::tzMutex_);
  return now >= impl::PLAUSIBLE_EPOCH;
}

void toLocal(time_t epoch, std::tm& out) {
  xSemaphoreTake(impl::tzMutex_, portMAX_DELAY);
  localtime_r(&epoch, &out);
  xSemaphoreGive(impl::tzMutex_);
}

uint32_t syncCount() {
  portENTER_CRITICAL(&impl::mux_);
  const uint32_t n = impl::syncCount_;
  portEXIT_CRITICAL(&impl::mux_);
  return n;
}

bool everSynced() { return syncCount() > 0; }

// Measured crystal drift versus NTP. Valid once the baseline is long enough to be meaningful.
// Valid once the baseline is long enough for the figure to beat its own noise. The old gate
// was 300 s, where a two-point estimate carries about +/- 67 ppm of uncertainty - larger than
// the quantity it measures, which is why a cold boot used to report figures like 127 ppm.
bool     driftValid() { return impl::driftSpanS_ >= DRIFT_VALID_SPAN_S; }
float    driftRecentPpm()   { return impl::recentPpm_; }
uint32_t driftRecentSpanS() { return impl::recentSpanS_; }

// One-sigma uncertainty of the current estimate, in ppm. NEGATIVE when nothing has been
// measured at all: returning 0 there reads exactly like a perfectly measured zero.
float driftUncertaintyPpm() {
  const uint32_t span = impl::driftSpanS_;
  if (span == 0) return -1.0f;
  return (2.0f * DRIFT_SYNC_JITTER_US) / (float)span;
}
float    driftPpm()   { return impl::driftPpm_; }
uint32_t driftSpanS() { return impl::driftSpanS_; }

time_t lastSyncEpoch() {
  portENTER_CRITICAL(&impl::mux_);
  const time_t t = impl::lastSyncEpoch_;
  portEXIT_CRITICAL(&impl::mux_);
  return t;
}

int64_t lastSyncAgeUs() {
  portENTER_CRITICAL(&impl::mux_);
  const int64_t t = impl::lastSyncUs_;
  portEXIT_CRITICAL(&impl::mux_);
  return t < 0 ? -1 : esp_timer_get_time() - t;
}

uint32_t syncIntervalS() { return impl::intervalS_; }
const char* server() { return impl::server_; }
const char* activeTz() { return impl::activeTz_; }

}  // namespace timekeeping

// ================================================================ SPOOF CONTROL
//
// One task rebuilds the DS1302 register image from local time every 20 ms and decides
// whether the ISR may answer reads. It also owns the two display sequences that drive
// deliberately fake times: the boot countdown (00:00, 03:00, 02:00, 01:00) and the
// display march started from the web UI.

namespace spoof {

struct Status {
  bool        armed;        // ISR answers clock reads
  bool        haveTime;     // image holds a real time (or a sequence time)
  bool        march;        // display march running
  bool        countdown;    // boot countdown running
  bool        hour12;       // hours register encoded in 12 hour mode
  uint8_t     reg[8];
  const char* reason;
};

namespace impl {

portMUX_TYPE mux_ = portMUX_INITIALIZER_UNLOCKED;
Status       status_ = {};
volatile int forcedHour_ = -1;          // display march (set from the web UI test)
volatile int forcedMin_ = 0;
volatile bool countdownWanted_ = false;
bool         countdownRunning_ = false;
uint8_t      countdownStep_ = 0;
uint32_t     countdownStepMs_ = BOOT_COUNTDOWN_STEP_MS;
uint32_t     countdownStartedMs_ = 0;

const uint8_t COUNTDOWN_HOURS[4] = { 0, 3, 2, 1 };

ds1302::HourMode resolveHourMode() {
#if HOUR_FORMAT_FORCE == 1
  return ds1302::HourMode::H24;              // pinned in firmware, outranks NVS and the UI
#elif HOUR_FORMAT_FORCE == 2
  return ds1302::HourMode::H12;
#else
  if (g_settings.hourFormat == HOURFMT_12) return ds1302::HourMode::H12;
  if (g_settings.hourFormat == HOURFMT_24) return ds1302::HourMode::H24;
  return bus::learnedHour() == 1 ? ds1302::HourMode::H12 : ds1302::HourMode::H24;
#endif
}

bool ntpFresh() {
#if NTP_HOLDOVER_HOURS == 0
  return WiFi.isConnected() && timekeeping::everSynced();
#else
  const int64_t age = timekeeping::lastSyncAgeUs();
  return age >= 0 && age <= (int64_t)NTP_HOLDOVER_HOURS * 3600LL * 1000000LL;
#endif
}

// Step length: at least one MCU polling cycle and a half, so every step is actually read.
uint32_t sequenceStepMs() {
  const uint32_t gapMs = bus::pollGapUs() / 1000;
  uint32_t ms = BOOT_COUNTDOWN_STEP_MS;
  if (gapMs + gapMs / 2 > ms) ms = gapMs + gapMs / 2;
  if (ms > 5000UL) ms = 5000UL;
  return ms;
}

void buildFromHm(const std::tm& base, bool baseValid, int hour, int minute,
                 ds1302::HourMode mode, uint8_t reg[8]) {
  std::tm t = base;
  if (!baseValid) { t.tm_year = 100; t.tm_mon = 0; t.tm_mday = 1; t.tm_wday = 6; }  // 2000-01-01
  t.tm_hour = hour;
  t.tm_min = minute;
  t.tm_sec = 0;
  ds1302::buildImage(t, mode, reg);
}

void imageTask(void*) {
  uint8_t    lastReg[8] = {};
  bool       lastArmed = false;
  bool       first = true;
  TickType_t wake = xTaskGetTickCount();

  for (;;) {
    std::tm tm = {};
    const bool timeOk = timekeeping::localNow(tm);
    const ds1302::HourMode mode = resolveHourMode();
    const uint32_t nowMs = millis();
    const int forced = forcedHour_;

    Status st = {};
    st.hour12 = (mode == ds1302::HourMode::H12);

    if (forced >= 0) {                                  // display march wins
      countdownRunning_ = false;
      countdownWanted_ = false;
      buildFromHm(tm, timeOk, forced, forcedMin_, mode, st.reg);
      st.armed = true; st.haveTime = true; st.march = true;
      st.reason = "on: display march";
    } else {
      const bool wouldArm = g_settings.spoofEnabled && timekeeping::everSynced() && ntpFresh();
      if (countdownWanted_ && wouldArm && !countdownRunning_) {
        countdownRunning_ = true;
        countdownStep_ = 0;
        countdownStepMs_ = sequenceStepMs();
        countdownStartedMs_ = nowMs;
      }
      if (countdownRunning_) {
        const uint32_t elapsed = nowMs - countdownStartedMs_;
        countdownStep_ = (uint8_t)(elapsed / countdownStepMs_);
        if (countdownStep_ >= (uint8_t)(sizeof COUNTDOWN_HOURS) || !wouldArm) {
          countdownRunning_ = false;
          countdownWanted_ = false;
        }
      }
      if (countdownRunning_) {
        buildFromHm(tm, timeOk, COUNTDOWN_HOURS[countdownStep_], 0, mode, st.reg);
        st.armed = true; st.haveTime = true; st.countdown = true;
        st.reason = "on: boot countdown";
      } else {
        if (timeOk) { ds1302::buildImage(tm, mode, st.reg); st.haveTime = true; }
#if RTC_CHIP_REMOVED
        // No chip on the bus: answer regardless of sync state. Until the first NTP sync,
        // hand out a valid BCD image so the MCU never latches garbage.
        if (!timeOk) {
          st.reg[0] = 0x00; st.reg[1] = 0x00; st.reg[2] = 0x00;
          st.reg[3] = 0x01; st.reg[4] = 0x01; st.reg[5] = 0x01; st.reg[6] = 0x26;
        }
        st.reg[7] = 0x80;                      // control register reads back write-protected
        st.armed = true; st.haveTime = true;
        st.reason = timekeeping::everSynced() ? "on: NTP time (DS1302 removed)"
                                              : "on: emulating, waiting for first NTP sync";
#else
        if (!g_settings.spoofEnabled)        st.reason = "off: spoof disabled (passthrough)";
        else if (!timekeeping::everSynced()) st.reason = "off: waiting for first NTP sync";
        else if (!ntpFresh())                st.reason = NTP_HOLDOVER_HOURS == 0
                                                 ? "off: Wi-Fi down (passthrough)"
                                                 : "off: NTP holdover expired (passthrough)";
        else { st.armed = true;              st.reason = "on: NTP time"; }
#endif
      }
    }

    if (first || st.armed != lastArmed || std::memcmp(st.reg, lastReg, 8) != 0) {
      bus::setImage(st.reg, st.armed);
      std::memcpy(lastReg, st.reg, 8);
      lastArmed = st.armed;
      first = false;
    }

    portENTER_CRITICAL(&mux_);
    status_ = st;
    portEXIT_CRITICAL(&mux_);

    xTaskDelayUntil(&wake, pdMS_TO_TICKS(20));
  }
}

}  // namespace impl

void begin() {
  impl::countdownWanted_ = g_settings.bootCountdown;
  xTaskCreate(impl::imageTask, "ds1302img", 4096, nullptr, 3, nullptr);
}

void getStatus(Status& out) {
  portENTER_CRITICAL(&impl::mux_);
  out = impl::status_;
  portEXIT_CRITICAL(&impl::mux_);
}

// hour 0..23 forces that time onto the display; hour < 0 returns to normal operation.
void setForced(int hour, int minute) {
  impl::forcedMin_ = minute;
  impl::forcedHour_ = hour;
}

// Replay the power-up countdown (also used by the web UI button).
void requestCountdown() {
  impl::countdownRunning_ = false;
  impl::countdownWanted_ = true;
}

bool countdownPending() { return impl::countdownWanted_ || impl::countdownRunning_; }

}  // namespace spoof

namespace diag {

struct Rates {
  float       cePerSec;     // CE assertions per second (last 1 s window)
  float       sclkHz;       // average SCLK frequency of recent transfers, 0 = none seen
  uint32_t    pollGapMs;    // latest gap between polling cycles, 0 = unknown
  const char* pollStyle;    // "burst", "per-register", "mixed", "none"
};

void begin();
void loop();                       // call every loop() pass

void getRates(Rates& out);

bool startPassiveCheck();          // false if a test is already running
bool startMarch();
bool startPinScan();               // watch every usable GPIO for edges
bool startIsrSelfTest();           // drive PIN_CE from the ESP32 and prove the ISR fires

bool        testRunning();
const char* testName();            // "passive", "march" or "" if none has run
uint32_t    testElapsedMs();
uint32_t    testDurationMs();      // planned length of the running/last test
const String& testReport();        // multi-line text; first line "RESULT: ..."

}  // namespace diag

// ---------------------------------------------------------------- implementation

namespace diag {
namespace impl {

enum class Kind : uint8_t { None, Passive, March, PinScan, IsrSelf };

constexpr uint8_t MARCH_STEPS   = 5;     // 01:00 .. 05:00
constexpr uint8_t STYLE_WINDOWS = 5;     // polling style judged over the last 5 s

struct RateState {
  bool        init = false;
  BusSnapshot prev = {};
  uint32_t    prevMs = 0;
  diag::Rates rates = { 0.0f, 0.0f, 0, "none" };
  uint32_t    singleHist[STYLE_WINDOWS] = {};
  uint32_t    burstHist[STYLE_WINDOWS] = {};
  uint8_t     histIdx = 0;
};

struct TestState {
  Kind        kind = Kind::None;
  bool        running = false;
  uint32_t    startMs = 0, durMs = 0, endMs = 0;
  BusSnapshot s0 = {};
  uint8_t     step = 0;
  uint32_t    stepStartMs = 0, stepMs = 1000;
  BusSnapshot stepSnap = {};
  uint32_t    answered[MARCH_STEPS] = {};
  uint32_t    unanswered[MARCH_STEPS] = {};
  String      report;
};

RateState R;
TestState T;

__attribute__((format(printf, 3, 4)))
void addf(String& s, const char* tag, const char* fmt, ...) {
  char buf[220];
  va_list ap;
  va_start(ap, fmt);
  vsnprintf(buf, sizeof buf, fmt, ap);
  va_end(ap);
  s += tag;
  s += ' ';
  s += buf;
  s += '\n';
}

const char* pollStyle(uint32_t single, uint32_t burst) {
  if (!single && !burst) return "none";
  if (!single) return "burst";
  if (!burst) return "per-register";
  return "mixed";
}

void updateRates(uint32_t now) {
  if (!R.init) { bus::snapshot(R.prev); R.prevMs = now; R.init = true; return; }
  const uint32_t dtMs = now - R.prevMs;
  if (dtMs < 1000) return;

  BusSnapshot cur;
  bus::snapshot(cur);
  R.rates.cePerSec = (float)(cur.c.ceRises - R.prev.c.ceRises) * 1000.0f / (float)dtMs;
  const uint32_t dSpan = cur.c.spanUsSum - R.prev.c.spanUsSum;
  const uint32_t dPer  = cur.c.spanPeriods - R.prev.c.spanPeriods;
  if (dPer && dSpan) R.rates.sclkHz = 1e6f * (float)dPer / (float)dSpan;   // keeps last value between polls
  R.rates.pollGapMs = cur.pollGapUs / 1000;

  R.singleHist[R.histIdx] = cur.c.singleReads - R.prev.c.singleReads;
  R.burstHist[R.histIdx]  = cur.c.burstReads - R.prev.c.burstReads;
  R.histIdx = (uint8_t)((R.histIdx + 1) % STYLE_WINDOWS);
  uint32_t s = 0, b = 0;
  for (uint8_t i = 0; i < STYLE_WINDOWS; ++i) { s += R.singleHist[i]; b += R.burstHist[i]; }
  R.rates.pollStyle = pollStyle(s, b);

  R.prev = cur;
  R.prevMs = now;
}

// ---- GPIO activity scan -------------------------------------------------------
// Borrows every usable pin on the C3 (GPIO0-10) with an any-edge interrupt for a few
// seconds. Finds bus traffic even if it is wired to a different pin than expected, and
// proves whether anything on the board is switching at all.
constexpr uint8_t SCAN_LAST = 10;
volatile uint32_t g_scanEdges[SCAN_LAST + 1];

void IRAM_ATTR scanIsr(void* arg) {
  const uint32_t p = (uint32_t)(uintptr_t)arg;
  if (p <= SCAN_LAST) g_scanEdges[p] = g_scanEdges[p] + 1;
}

void scanAttach() {
  gpio_intr_disable((gpio_num_t)PIN_CE);
  gpio_isr_handler_remove((gpio_num_t)PIN_CE);
  for (uint8_t p = 0; p <= SCAN_LAST; ++p) {
    g_scanEdges[p] = 0;
    gpio_config_t c = {};
    c.pin_bit_mask = 1ULL << p;
    c.mode = GPIO_MODE_INPUT;
    c.pull_up_en = GPIO_PULLUP_DISABLE;
    c.pull_down_en = GPIO_PULLDOWN_DISABLE;
    c.intr_type = GPIO_INTR_ANYEDGE;
    if (gpio_config(&c) != ESP_OK) continue;
    gpio_isr_handler_add((gpio_num_t)p, scanIsr, (void*)(uintptr_t)p);
    gpio_intr_enable((gpio_num_t)p);
  }
}

void finishPinScan() {
  const uint32_t levels = REG_READ(GPIO_IN_REG);
  uint32_t edges[SCAN_LAST + 1];
  for (uint8_t p = 0; p <= SCAN_LAST; ++p) {
    edges[p] = g_scanEdges[p];
    gpio_intr_disable((gpio_num_t)p);
    gpio_isr_handler_remove((gpio_num_t)p);
  }
  bus::begin();                       // restore the normal tap on CE/SCLK/IO

  unsigned long total = 0;
  for (uint8_t p = 0; p <= SCAN_LAST; ++p) total += edges[p];

  String r = total ? "RESULT: PASS\n" : "RESULT: FAIL\n";
  addf(r, "INFO", "Watched GPIO0-%u for %.1f s with any-edge interrupts",
       (unsigned)SCAN_LAST, (double)(T.durMs / 1000.0f));
  for (uint8_t p = 0; p <= SCAN_LAST; ++p) {
    const char* who = (p == PIN_CE)   ? "  <- CE, DS1302 pin 5"
                    : (p == PIN_SCLK) ? "  <- SCLK, DS1302 pin 7"
                    : (p == PIN_IO)   ? "  <- I/O, DS1302 pin 6" : "";
    addf(r, edges[p] ? "PASS" : "INFO", "GPIO%-2u edges=%-8lu level=%u%s",
         (unsigned)p, (unsigned long)edges[p], (unsigned)((levels >> p) & 1u), who);
  }
  if (!total)
    addf(r, "FAIL", "No edges on ANY pin. Nothing reaching this board is switching: either the clock MCU does not read the DS1302 while running, or no wire carries the signal to the ESP32.");
  else if (!edges[PIN_CE])
    addf(r, "FAIL", "Edges exist, but not on GPIO%u. The CE wire is landing on a different pin: use the pin above that shows edges.", (unsigned)PIN_CE);
  T.report = r;
}

void finishPassive() {
  BusSnapshot s1;
  bus::snapshot(s1);
  const BusCounters& a = T.s0.c;
  const BusCounters& b = s1.c;
  const unsigned long ce      = b.ceRises - a.ceRises;
  const unsigned long single  = b.singleReads - a.singleReads;
  const unsigned long burst   = b.burstReads - a.burstReads;
  const unsigned long writes  = b.writes - a.writes;
  const unsigned long invalid = b.invalid - a.invalid;
  const unsigned long late    = b.misaligned - a.misaligned;
  const unsigned long lateEdg = b.lateEdge - a.lateEdge;
  const unsigned long glitch  = b.glitches - a.glitches;
  const unsigned long slow    = b.tooSlow - a.tooSlow;
  const unsigned long tmo     = b.timeouts - a.timeouts;
  const unsigned long lng     = b.longTxn - a.longTxn;
  const unsigned long inc     = b.incomplete - a.incomplete;
  const unsigned long spoofed = b.spoofed - a.spoofed;
  const unsigned long pass    = b.passReads - a.passReads;
  const unsigned long valid   = single + burst + writes;
  const float secs = (float)T.durMs / 1000.0f;

  String r;
  bool ok = true;
  addf(r, "INFO", "Window %.1f s: %lu CE rises (%.1f/s)", secs, ce, (float)ce / secs);
  if (ce == 0) {
    ok = false;
    addf(r, "FAIL", "No CE rising edges. Check DS1302 pin 5 -> GPIO%d, common GND, level shifting.", PIN_CE);
  } else {
    addf(r, "PASS", "CE is toggling");
    if (valid == 0) {
      ok = false;
      addf(r, "FAIL", "CE toggles but no valid command byte decoded. Check SCLK (pin 7 -> GPIO%d) and I/O (pin 6 -> GPIO%d).",
           PIN_SCLK, PIN_IO);
    } else {
      addf(r, "PASS", "%lu valid command bytes: %lu single reads, %lu burst reads, %lu writes",
           valid, single, burst, writes);
    }
  }
  if (invalid)       addf(r, "WARN", "%lu command bytes with bit7=0 (noise, wrong pad, or ISR entered mid-transfer)", invalid);
  if (late || glitch) addf(r, "WARN", "ISR entered late: %lu with SCLK already high, %lu with CE already low", late, glitch);
  if (lateEdg) {
    addf(r, "WARN", "%lu of %lu transfers had an SCLK edge before the ISR ran; those are never answered", lateEdg, ce);
    if (lateEdg * 10 >= ce * 9)
      addf(r, "WARN", "That is nearly every transfer: SCLK is likely clocked while CE is low (shared line). If so, set BUS_SLIP_GUARD 0.");
  }
  if (slow || tmo || lng) addf(r, "WARN", "Not followed: %lu over ISR budget, %lu timed out, %lu RAM bursts", slow, tmo, lng);
  if (inc)           addf(r, "INFO", "%lu transfers ended before all data bits were clocked", inc);

  String cmds;
  char d[48];
  for (int c = 0; c < 256; ++c) {
    if (s1.cmdSeen[c >> 5] & (1UL << (c & 31))) {
      ds1302::describeCmd((uint8_t)c, d, sizeof d);
      cmds += "       ";
      cmds += d;
      cmds += '\n';
    }
  }
  if (cmds.length()) { r += "INFO Command bytes seen:\n"; r += cmds; }

  addf(r, "INFO", "Polling: %s, cycle gap %lu ms", pollStyle(single, burst), (unsigned long)(s1.pollGapUs / 1000));
  const uint32_t dSpan = b.spanUsSum - a.spanUsSum;
  const uint32_t dPer  = b.spanPeriods - a.spanPeriods;
  if (dPer && dSpan)
    addf(r, "INFO", "SCLK average %.0f Hz (%.1f us per clock)", 1e6f * (float)dPer / (float)dSpan, (float)dSpan / (float)dPer);

  if (spoofed) {
    addf(r, "INFO", "Spoof answered %lu reads in this window; turn spoof off to capture the real chip's data", spoofed);
  } else if (pass && s1.realMask == 0x7F && s1.realUs != T.s0.realUs) {
    char t[48];
    ds1302::formatImage(s1.real, t, sizeof t);
    if (ds1302::imageLooksValid(s1.real)) {
      addf(r, "PASS", "I/O data decodes as a valid time: %s (compare with the display)", t);
    } else {
      ok = false;
      addf(r, "FAIL", "Captured clock bytes are not valid BCD [%02X %02X %02X %02X %02X %02X %02X]: I/O wire or sampling",
           s1.real[0], s1.real[1], s1.real[2], s1.real[3], s1.real[4], s1.real[5], s1.real[6]);
    }
  } else if (valid) {
    addf(r, "WARN", "No complete clock read captured (registers 0-6): data line not verified");
  }

  addf(r, "INFO", "MCU hour format: %s", s1.learnedHour < 0 ? "unknown" : (s1.learnedHour ? "12h" : "24h"));
  T.report = String("RESULT: ") + (ok ? "PASS" : "FAIL") + "\n" + r;
}

void finishMarch() {
  String r;
  bool ok = true;
  addf(r, "INFO", "Step length %.1f s (MCU polling gap %lu ms)", (float)T.stepMs / 1000.0f,
       (unsigned long)(T.stepSnap.pollGapUs / 1000));
  for (uint8_t i = 0; i < MARCH_STEPS; ++i) {
    const unsigned long ans = T.answered[i];
    const unsigned long un  = T.unanswered[i];
    if (ans == 0) {
      ok = false;
      addf(r, "FAIL", "%02u:00  no read answered (%lu reads left to the real chip)", i + 1u, un);
    } else {
      addf(r, "PASS", "%02u:00  answered %lu reads, %lu not answered", i + 1u, ans, un);
    }
  }
  if (ok) addf(r, "INFO", "Bus side OK. The ESP32 cannot see the display: confirm the digits walked 01:00 -> 05:00.");
  else    addf(r, "INFO", "Run the passive bus check: unanswered reads show up there as late ISR entry, over budget or unsupported commands.");
  addf(r, "INFO", "Reverted to normal operation (NTP time if spoof is on and synced, otherwise passthrough).");
  T.report = String("RESULT: ") + (ok ? "PASS (bus side)" : "FAIL") + "\n" + r;
}

void runMarch(uint32_t now) {
  if (now - T.stepStartMs < T.stepMs) return;
  BusSnapshot cur;
  bus::snapshot(cur);
  const uint32_t reads = (cur.c.singleReads + cur.c.burstReads) - (T.stepSnap.c.singleReads + T.stepSnap.c.burstReads);
  const uint32_t sp = cur.c.spoofed - T.stepSnap.c.spoofed;
  T.answered[T.step] = sp;
  T.unanswered[T.step] = reads - sp;
  T.stepSnap = cur;
  if (++T.step < MARCH_STEPS) {
    spoof::setForced(T.step + 1, 0);
    T.stepStartMs = now;
    return;
  }
  spoof::setForced(-1, 0);
  finishMarch();
  T.running = false;
  T.endMs = now;
}

}  // namespace impl

using namespace impl;

void begin() { T.report = "RESULT: none\n"; }

void loop() {
  const uint32_t now = millis();
  updateRates(now);
  if (!T.running) return;
  if (T.kind == Kind::March) { runMarch(now); return; }
  if (now - T.startMs >= T.durMs) {
    if (T.kind == Kind::PinScan) finishPinScan(); else finishPassive();
    T.running = false;
    T.endMs = now;
  }
}

void getRates(Rates& out) { out = R.rates; }

bool startPassiveCheck() {
  if (T.running) return false;
  BusSnapshot cur;
  bus::snapshot(cur);
  T.durMs = std::min<uint32_t>(std::max<uint32_t>(3000, (cur.pollGapUs / 1000) * 3), 10000);
  bus::clearCmdSeen();
  bus::snapshot(T.s0);
  T.kind = Kind::Passive;
  T.startMs = millis();
  T.report = "RESULT: running\n";
  T.running = true;
  return true;
}

bool startMarch() {
  if (T.running) return false;
  bus::snapshot(T.stepSnap);
  const uint32_t gapMs = T.stepSnap.pollGapUs / 1000;
  T.stepMs = std::min<uint32_t>(std::max<uint32_t>(1000, gapMs + gapMs / 2), 5000);
  T.durMs = T.stepMs * MARCH_STEPS;
  for (uint8_t i = 0; i < MARCH_STEPS; ++i) { T.answered[i] = 0; T.unanswered[i] = 0; }
  T.step = 0;
  T.kind = Kind::March;
  T.startMs = T.stepStartMs = millis();
  T.report = "RESULT: running\n";
  T.running = true;
  spoof::setForced(1, 0);
  return true;
}

bool startPinScan() {
  if (T.running) return false;
  T.durMs = 5000;
  scanAttach();
  T.kind = Kind::PinScan;
  T.startMs = millis();
  T.report = "RESULT: running\n";
  T.running = true;
  return true;
}

// Synchronous: drives PIN_CE from the ESP32 itself and checks the CE interrupt fired.
// Current into the outside world is limited by the series resistor on the wire.
bool startIsrSelfTest() {
  if (T.running) return false;
  BusSnapshot s0;
  bus::snapshot(s0);
  const unsigned long before = s0.c.ceRises;
  const uint8_t pulses = 3;

  gpio_set_level((gpio_num_t)PIN_CE, 0);
  gpio_set_direction((gpio_num_t)PIN_CE, GPIO_MODE_INPUT_OUTPUT);
  for (uint8_t i = 0; i < pulses; ++i) {
    gpio_set_level((gpio_num_t)PIN_CE, 0);
    delayMicroseconds(300);
    gpio_set_level((gpio_num_t)PIN_CE, 1);
    delayMicroseconds(300);
    gpio_set_level((gpio_num_t)PIN_CE, 0);
    delayMicroseconds(300);
  }
  gpio_set_direction((gpio_num_t)PIN_CE, GPIO_MODE_INPUT);

  BusSnapshot s1;
  bus::snapshot(s1);
  const unsigned long got = s1.c.ceRises - before;

  String r = (got >= pulses) ? "RESULT: PASS\n" : "RESULT: FAIL\n";
  addf(r, "INFO", "Generated %u rising edges on GPIO%u from the ESP32 itself",
       (unsigned)pulses, (unsigned)PIN_CE);
  addf(r, got >= pulses ? "PASS" : "FAIL", "CE interrupt fired %lu time(s)", got);
  if (got >= pulses)
    addf(r, "INFO", "GPIO config, interrupt and ISR all work. Zero edges during normal running is therefore a missing signal, not a firmware fault.");
  else
    addf(r, "FAIL", "Interrupt did not fire on a self-generated edge: that is a firmware/GPIO fault.");
  addf(r, "INFO", "Timeout and invalid counters tick up from this test: the edges had no SCLK behind them. Expected.");
  T.report = r;
  T.kind = Kind::IsrSelf;
  T.running = false;
  T.startMs = T.endMs = millis();
  T.durMs = 0;
  return true;
}

bool testRunning() { return T.running; }

const char* testName() {
  switch (T.kind) {
    case Kind::Passive: return "passive";
    case Kind::March:   return "march";
    case Kind::PinScan: return "gpio scan";
    case Kind::IsrSelf: return "isr self-test";
    default:            return "";
  }
}

uint32_t testElapsedMs() {
  if (T.kind == Kind::None) return 0;
  return (T.running ? millis() : T.endMs) - T.startMs;
}

uint32_t testDurationMs() { return T.durMs; }

const String& testReport() { return T.report; }

}  // namespace diag

// ================================================================ WI-FI MANAGER
//
// The device never stops trying to reconnect. Retries back off from WIFI_RETRY_MIN_MS to
// WIFI_RETRY_MAX_MS, and every WIFI_RADIO_RESET_TRIES failures the radio is taken down and
// brought back up, which clears driver states that a plain begin() does not.

namespace wifimgr {

struct Stats {
  uint32_t connects;
  uint32_t disconnects;
  uint32_t retries;
  uint32_t radioResets;
  uint8_t  lastReason;
  uint32_t downSinceMs;     // millis() when the link was last lost, 0 while connected
};

namespace impl {

Stats    stats_ = {};
uint32_t lastAttemptMs_ = 0;
uint32_t retryDelayMs_ = WIFI_RETRY_MIN_MS;
bool     txApplied_ = false;
uint32_t failStreak_ = 0;
volatile bool gotIp_ = false;

void onEvent(arduino_event_id_t event, arduino_event_info_t info) {
  switch (event) {
    case ARDUINO_EVENT_WIFI_STA_GOT_IP:
      ++stats_.connects;
      stats_.downSinceMs = 0;
      failStreak_ = 0;
      retryDelayMs_ = WIFI_RETRY_MIN_MS;
      gotIp_ = true;
      break;
    case ARDUINO_EVENT_WIFI_STA_DISCONNECTED:
      ++stats_.disconnects;
      stats_.lastReason = info.wifi_sta_disconnected.reason;
      if (!stats_.downSinceMs) {
        const uint32_t t = millis();
        stats_.downSinceMs = t ? t : 1;
      }
      break;
    default:
      break;
  }
}

}  // namespace impl

const char* reasonName(uint8_t reason) {
  switch (reason) {
    case 0:   return "none";
    case 1:   return "unspecified";
    case 2:   return "auth expired";
    case 4:   return "association expired";
    case 8:   return "AP dropped us";
    case 15:  return "4-way handshake timeout (check the password)";
    case 200: return "beacon timeout";
    case 201: return "no AP found";
    case 202: return "auth failed";
    case 203: return "association failed";
    case 204: return "handshake timeout";
    case 205: return "connection failed";
    default:  return "see esp_wifi_types.h";
  }
}

// Both knobs revert to their defaults whenever the radio restarts, so this runs after every
// STA start, not once at boot. setTxPower needs the station already started or it refuses.
void applyRadioPower() {
  const wifi_ps_type_t ps = g_settings.wifiPsMode == 2 ? WIFI_PS_MAX_MODEM
                          : g_settings.wifiPsMode == 1 ? WIFI_PS_MIN_MODEM
                                                       : WIFI_PS_NONE;
  WiFi.setSleep(ps);
  esp_wifi_set_ps(ps);
  // 0.25 dBm units. quantiseTxDbm has already snapped the value to a producible step.
  const int8_t q = (int8_t)(g_settings.wifiTxDbm * 4);
  impl::txApplied_ = WiFi.setTxPower((wifi_power_t)q);
}

void begin() {
  WiFi.persistent(false);                 // credentials come from the configuration block
  WiFi.setHostname(DEVICE_HOSTNAME);      // must precede WiFi.mode()
  WiFi.onEvent(impl::onEvent);
  WiFi.mode(WIFI_STA);
  WiFi.setAutoReconnect(true);
  WiFi.begin(WIFI_SSID, WIFI_PASSWORD);
  applyRadioPower();
  const uint32_t t = millis();
  impl::lastAttemptMs_ = t;
  impl::stats_.downSinceMs = t ? t : 1;
}

void loop() {
  const uint32_t now = millis();
  if (WiFi.isConnected()) {
    impl::retryDelayMs_ = WIFI_RETRY_MIN_MS;
    impl::failStreak_ = 0;
    return;
  }
  if (now - impl::lastAttemptMs_ < impl::retryDelayMs_) return;
  impl::lastAttemptMs_ = now;
  ++impl::stats_.retries;
  ++impl::failStreak_;

  if (impl::failStreak_ % WIFI_RADIO_RESET_TRIES == 0) {
    ++impl::stats_.radioResets;
    WiFi.disconnect(true, false);
    WiFi.mode(WIFI_OFF);
    delay(100);
    WiFi.mode(WIFI_STA);
  }
  WiFi.begin(WIFI_SSID, WIFI_PASSWORD);
  applyRadioPower();

  impl::retryDelayMs_ *= 2;
  if (impl::retryDelayMs_ > WIFI_RETRY_MAX_MS) impl::retryDelayMs_ = WIFI_RETRY_MAX_MS;
}

// What the radio reports back, not what we asked for. 0 when the station is not started.
int8_t actualTxDbm() {
  if (!WiFi.isConnected()) return 0;
  const int v = (int)WiFi.getTxPower();
  return (int8_t)(v / 4);
}
bool txApplied() { return impl::txApplied_; }

// True once per new IP; clears the flag.
bool takeGotIp() {
  if (!impl::gotIp_) return false;
  impl::gotIp_ = false;
  return true;
}

void getStats(Stats& out) { out = impl::stats_; }
uint32_t retryDelayMs() { return impl::retryDelayMs_; }

uint32_t downSeconds() {
  if (WiFi.isConnected() || !impl::stats_.downSinceMs) return 0;
  return (millis() - impl::stats_.downSinceMs) / 1000;
}

}  // namespace wifimgr

// ================================================================ WEB PAGE

// Web UI page, gzipped, stored as a byte array (not a raw string) and kept in the .ino.
// A multi-line raw string in a .ino gets #line directives injected by the Arduino sketch
// preprocessor, which corrupts the served HTML. A byte array is immune. Regenerate from
// web_page.h if the page changes.
static const uint8_t INDEX_HTML_GZ[] PROGMEM = {
  31,139,8,0,0,0,0,0,2,255,197,125,253,123,218,198,178,255,239,252,
  21,91,218,147,64,3,50,224,151,56,96,236,235,56,238,73,218,56,241,19,
  147,166,167,125,122,137,64,11,40,22,18,213,74,198,142,195,253,219,191,159,
  153,93,9,9,132,67,114,239,243,124,79,78,49,90,205,236,204,206,206,206,
  203,190,113,244,131,19,12,163,187,153,20,147,104,234,29,151,142,232,143,240,
  108,127,220,45,75,191,124,124,52,145,182,115,124,52,149,145,45,134,19,59,
  84,50,234,150,227,104,84,63,44,155,82,223,158,202,110,249,198,149,243,89,
  16,70,101,49,12,252,72,250,128,154,187,78,52,233,58,242,198,29,202,58,
  63,212,92,223,141,92,219,171,171,161,237,201,110,179,12,122,145,27,121,242,
  248,77,239,82,156,121,193,240,90,92,4,206,209,142,46,44,29,169,232,142,
  254,182,195,32,136,238,235,245,193,184,253,227,104,15,255,154,157,122,125,104,
  135,14,30,71,35,124,31,225,69,115,136,127,54,30,166,113,212,254,241,192,
  198,191,61,60,121,174,47,219,63,202,134,108,56,244,50,184,6,164,243,212,
  222,125,134,135,185,29,250,237,31,159,237,29,180,26,13,60,14,108,84,56,
  216,107,237,54,15,241,100,15,135,4,186,39,157,195,69,233,191,166,210,113,
  237,202,44,148,35,25,170,250,48,240,130,16,173,152,200,169,108,59,118,120,
  93,189,207,242,216,220,197,191,86,202,99,211,193,191,129,97,83,14,240,239,
  48,97,243,217,0,255,246,83,54,119,91,187,173,150,52,108,238,217,142,60,
  108,164,108,142,6,131,81,107,47,97,115,116,248,180,249,180,153,176,249,212,
  182,91,163,209,98,81,250,249,126,16,220,214,149,251,217,245,199,237,65,16,
  58,50,172,163,100,49,8,156,187,251,169,29,142,93,191,221,232,140,208,69,
  237,230,222,236,118,167,105,237,237,11,117,167,34,57,173,199,110,173,110,207,
  102,158,172,235,130,218,149,28,7,82,188,127,85,83,182,175,234,74,134,238,
  168,51,176,135,215,227,48,136,125,167,125,99,135,21,106,111,181,195,226,48,
  207,163,113,117,81,154,218,174,15,114,183,186,219,219,135,135,141,217,109,39,
  33,47,236,56,10,58,51,219,113,136,201,230,193,236,118,81,34,45,147,225,
  189,227,170,153,103,223,181,71,158,188,237,208,71,125,30,218,179,54,125,116,
  108,207,29,251,117,23,140,169,246,16,10,38,195,206,24,239,128,46,168,41,
  73,245,248,42,26,194,212,218,188,167,166,146,60,100,187,249,52,195,195,226,
  199,33,105,27,191,110,31,52,26,162,69,245,196,110,125,26,248,129,154,217,
  67,89,187,144,190,23,212,206,2,95,5,158,173,106,233,139,69,201,162,110,
  189,95,147,4,149,86,59,90,232,237,38,170,3,162,235,8,253,146,250,55,
  121,89,15,109,199,141,85,187,73,82,73,229,64,140,19,219,134,71,116,91,
  20,5,83,46,71,75,90,217,150,180,0,21,201,219,168,30,133,232,153,81,
  16,78,219,241,108,38,195,161,173,100,199,147,17,100,83,39,94,169,94,171,
  241,84,78,115,61,4,197,171,46,59,163,33,14,137,64,100,15,60,121,175,
  187,171,217,104,252,43,97,21,136,158,61,83,178,157,124,89,68,206,125,194,
  243,62,201,186,115,35,195,200,197,128,174,115,15,181,163,96,150,32,227,107,
  177,32,64,47,108,143,220,80,69,245,225,196,245,28,129,74,51,56,13,16,
  201,190,190,95,99,95,51,186,123,240,175,68,126,245,208,29,79,34,22,13,
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
};


// ================================================================ WEB SERVER
//
// Security posture (LAN device, no internet exposure intended):
//   - Host header must match this device, which blocks DNS-rebinding attacks from a
//     browser that has been pointed at our IP by a hostile name server.
//   - Every state-changing call is POST, must carry X-Requested-With, and any Origin
//     header must match. A browser cannot set that header cross-origin without a
//     preflight, and no CORS headers are served, so other sites cannot drive the device.
//   - Optional HTTP basic auth (WEB_AUTH_USER / WEB_AUTH_PASS).
//   - Every field is validated and length-bounded before it reaches NVS or SNTP.
//   - Responses never contain the Wi-Fi password or any other secret.

// ================================================================ TEMPERATURE OUTPUT
namespace tempout {

// Temperature -> raw curve. Divider solved from two measurements on this board: node at
// 2.00 V on the 5 V rail gives NTC = 1.5 x lower leg, and 1.59k measured in circuit across
// the bead pads is NTC in parallel with that leg. Together: lower leg 2.7k, bead 4.0k at
// 21 C, i.e. a 3.3k NTC. The clock therefore expects 1.11 V at 0 C to 2.93 V at 40 C.
//
// MEASURED on this board 2026-09-13 with 220 ohm and 2.2 uF fitted, 9-bit duty. Each pair is
// a raw value driven by the temperature march and the number the clock face actually settled
// on. Not a model - re-measure with the march if the resistor, the capacitor, TEMP_PWM_BITS
// or the board changes, because every one of those moves the raw scale.
//
// The nine measured points fit a single NTC curve to +/-0.5 C (least squares: B = 3576 K,
// R25 = 2983 ohm), which is what says the readings are real and not noise. Residuals are
// 4/8 positive, mean 0.00, so the clock ROUNDS rather than truncating - no half-degree bias.
//
// { 39, 509 } is the one EXTRAPOLATED entry, read off that fitted curve 2 C past the last
// measured point. Full duty 511 is the hard ceiling, about 39.3 C. Verify it if it ever matters.
struct TempPoint { int8_t c; uint16_t raw; };
const TempPoint TEMP_CURVE[] = {
  {  0, 186 }, {  4, 220 }, {  8, 258 }, { 13, 297 }, { 18, 337 },
  { 22, 377 }, { 27, 416 }, { 32, 455 }, { 37, 491 }, { 39, 509 },
};
const uint8_t TEMP_CURVE_N = sizeof TEMP_CURVE / sizeof TEMP_CURVE[0];

// Raw ripple sweep. Step 0 is a constant low and the last step is 99.8 percent duty, both
// effectively DC; every step between them is a real square wave. If the clock face is steady
// on the two ends and jumps on the middle steps, the node has no usable low-pass filter and
// the MCU is sampling PWM ripple - that is a hardware fix, not a firmware one.
const uint16_t RAW_SWEEP[] = { 0, TEMP_RAW_MAX / 8, TEMP_RAW_MAX / 4, (TEMP_RAW_MAX * 3) / 8,
                               TEMP_RAW_MAX / 2, (TEMP_RAW_MAX * 5) / 8, (TEMP_RAW_MAX * 3) / 4,
                               (TEMP_RAW_MAX * 7) / 8, TEMP_RAW_MAX };
const uint8_t RAW_SWEEP_N = sizeof RAW_SWEEP / sizeof RAW_SWEEP[0];

// Output sources, highest priority first: march beats hold, hold beats the ambient target,
// and the manual raw value is the fallback. evaluate() picks one every time anything changes,
// so an expiring hold needs no saved previous value to restore.
namespace impl {
uint16_t raw_        = 0;        // what is currently on the pin
uint16_t rawManual_  = 0;        // persisted fallback
bool     attached_   = false;
uint32_t freqHz_     = 0;        // frequency actually achieved, 0 = nothing attached
float    offsetC_    = 0.0f;     // calibration: display reads low by this much

bool     targetValid_ = false;   // ambient temperature (weather feed)
float    targetC_     = 0.0f;

uint32_t holdUntil_ = 0;         // 0 = no hold active
float    holdC_     = 0.0f;

bool     marchRunning_ = false;
bool     marchRaw_     = false;   // true = stepping RAW_SWEEP, false = stepping TEMP_CURVE
uint8_t  marchStep_    = 0;
uint32_t marchNext_    = 0;
uint32_t marchDwell_   = TEMP_MARCH_STEP_MS;

bool     negActive_ = false;     // driving a sub-zero magnitude
bool     negLow_    = false;     // blink phase: true = showing 0 C
uint32_t negNext_   = 0;

void applyRaw(uint16_t v) {                 // drive only, no NVS write
  if (v > TEMP_RAW_MAX) v = TEMP_RAW_MAX;
  raw_ = v;
  if (attached_) ledcWrite(TEMP_OUT_PIN, v);
}
}

// Calibrated temperature -> raw. Saturates at both ends of the curve.
// Snap a requested temperature to what the face can actually show. Applied BEFORE the
// calibration offset, deliberately: the offset exists to nudge a reading that lands just the
// wrong side of a boundary, and quantising after it would discard every nudge smaller than a
// whole degree, which is all of them.
float quantiseC(float c) {
#if TEMP_WHOLE_DEGREES == 1
  return (float)(long)c;                      // toward zero: 21.9 -> 21, -3.7 -> -3
#elif TEMP_WHOLE_DEGREES == 2
  return (float)(long)(c >= 0.0f ? c + 0.5f : c - 0.5f);
#else
  return c;
#endif
}

uint16_t rawForC(float c) {
  c += impl::offsetC_;
  if (c <= (float)TEMP_CURVE[0].c) return TEMP_CURVE[0].raw;
  if (c >= (float)TEMP_CURVE[TEMP_CURVE_N - 1].c) return TEMP_CURVE[TEMP_CURVE_N - 1].raw;
  for (uint8_t i = 1; i < TEMP_CURVE_N; ++i) {
    if (c <= (float)TEMP_CURVE[i].c) {
      const float lo = (float)TEMP_CURVE[i - 1].c, hi = (float)TEMP_CURVE[i].c;
      const float f = (c - lo) / (hi - lo);
      return (uint16_t)(TEMP_CURVE[i - 1].raw +
                        f * (float)(TEMP_CURVE[i].raw - TEMP_CURVE[i - 1].raw) + 0.5f);
    }
  }
  return TEMP_CURVE[TEMP_CURVE_N - 1].raw;
}

namespace impl {

// Drive one temperature, encoding sub-zero values as a magnitude the display can show.
// Quantised here rather than inside rawForC so the march and a manual hold can still ask for
// an exact value when a test wants one.
void driveC(float cIn) {
  const float c = quantiseC(cIn);
  if (c >= 0.0f) {
    negActive_ = false;
    applyRaw(rawForC(c));
    return;
  }
  if (!negActive_) {                        // entering the sub-zero encoding
    negActive_ = true;
    negLow_ = false;
    negNext_ = millis() + TEMP_NEG_HIGH_MS;
  }
#if TEMP_NEG_BLINK
  applyRaw(negLow_ ? rawForC(0.0f) : rawForC(-c));
#else
  applyRaw(rawForC(-c));
#endif
}

uint8_t marchSteps() { return marchRaw_ ? RAW_SWEEP_N : TEMP_CURVE_N; }

uint16_t marchRawAt(uint8_t i) {
  if (marchRaw_) return i < RAW_SWEEP_N ? RAW_SWEEP[i] : 0;
  return i < TEMP_CURVE_N ? TEMP_CURVE[i].raw : 0;
}

void evaluate() {
  if (marchRunning_) { negActive_ = false; applyRaw(marchRawAt(marchStep_)); return; }
  if (holdUntil_)    { driveC(holdC_);    return; }
  if (targetValid_)  { driveC(targetC_);  return; }
  negActive_ = false;
  applyRaw(rawManual_);
}
}

void begin() {
#if TEMP_OUT_ENABLE
  Preferences p;
  if (p.begin("ntpclock", true)) {
    impl::rawManual_ = p.getUShort("traw", 0);
    impl::offsetC_ = p.getFloat("toff", 0.0f);
    p.end();
  }
  if (impl::rawManual_ > TEMP_RAW_MAX) impl::rawManual_ = TEMP_RAW_MAX;

  // ledcAttach fails outright when frequency x 2^bits exceeds the LEDC source clock, and a
  // failure here means the pin is never driven. Walk down until one takes, and say which.
  static const uint32_t kFreqs[] = { TEMP_PWM_FREQ_HZ, TEMP_PWM_FALLBACKS };
  impl::attached_ = false;                  // never report a stale attach from an earlier call
  impl::freqHz_ = 0;
  for (uint8_t i = 0; i < sizeof kFreqs / sizeof kFreqs[0]; ++i) {
    if (ledcAttach(TEMP_OUT_PIN, kFreqs[i], TEMP_PWM_BITS)) {
      impl::attached_ = true;
      impl::freqHz_ = kFreqs[i];
      if (i) Serial.printf("WARN: temp PWM fell back to %lu Hz (%lu Hz refused)\n",
                           (unsigned long)kFreqs[i], (unsigned long)TEMP_PWM_FREQ_HZ);
      else   Serial.printf("Temp PWM: GPIO%d at %lu Hz, %d bits (0-%d)\n", TEMP_OUT_PIN,
                           (unsigned long)kFreqs[i], TEMP_PWM_BITS, TEMP_RAW_MAX);
      break;
    }
  }
  if (!impl::attached_)
    Serial.printf("ERROR: temp PWM refused every frequency on GPIO%d - output is dead\n",
                  TEMP_OUT_PIN);
  impl::evaluate();
#endif
}

uint16_t raw()           { return impl::raw_; }
bool     attached()      { return impl::attached_; }
uint32_t freqHz()        { return impl::freqHz_; }
float    offsetC()       { return impl::offsetC_; }
bool     marchRunning()  { return impl::marchRunning_; }
bool     marchIsRaw()    { return impl::marchRaw_; }
uint8_t  marchStep()     { return impl::marchStep_; }
uint8_t  marchSteps()    { return impl::marchSteps(); }
uint32_t marchDwellS()   { return impl::marchDwell_ / 1000UL; }
// Temperature the current march step corresponds to. Meaningless during a raw sweep.
int      marchStepC()    { return impl::marchStep_ < TEMP_CURVE_N
                                    ? (int)TEMP_CURVE[impl::marchStep_].c : 0; }
bool     negActive()     { return impl::negActive_; }
bool     targetValid()   { return impl::targetValid_; }
float    targetC()       { return impl::targetC_; }
// What actually reaches the face, after whole-degree snapping. Reported next to the raw
// reading so the UI and the display cannot disagree.
float    quantisedTargetC() { return quantiseC(impl::targetC_); }

// Whole seconds of hold left. Guards the wrap: millis() can pass holdUntil_ before loop()
// clears it, and an unsigned subtract there would report ~49 days remaining.
uint32_t holdLeftS() {
  if (!impl::holdUntil_) return 0;
  const int32_t left = (int32_t)(impl::holdUntil_ - millis());
  return left > 0 ? (uint32_t)left / 1000UL : 0;
}

void setRaw(uint16_t v) {
#if TEMP_OUT_ENABLE
  impl::holdUntil_ = 0;                  // a manual value overrides hold, march and ambient
  impl::marchRunning_ = false;
  impl::targetValid_ = false;
  impl::rawManual_ = v > TEMP_RAW_MAX ? TEMP_RAW_MAX : v;
  impl::evaluate();
  Preferences p;                       // manual action only, not a loop: NVS write is fine
  if (p.begin("ntpclock", false)) { p.putUShort("traw", impl::rawManual_); p.end(); }
#endif
}

void setOffsetC(float c) {
  if (c < -20.0f) c = -20.0f;
  if (c >  20.0f) c =  20.0f;
  impl::offsetC_ = c;
  impl::evaluate();                      // recalibrate whatever is on the pin right now
  Preferences p;
  if (p.begin("ntpclock", false)) { p.putFloat("toff", c); p.end(); }
}

// Ambient temperature from the weather feed. Persists until cleared; survives hold and march.
void setTargetC(float c) {
  impl::targetC_ = c;
  impl::targetValid_ = true;
  impl::evaluate();
}

void clearTarget() {
  impl::targetValid_ = false;
  impl::evaluate();
}

// Show a known temperature for a while. When it expires evaluate() falls back on its own.
void holdC(float c, uint32_t ms) {
  impl::marchRunning_ = false;
  impl::holdC_ = c;
  impl::holdUntil_ = millis() + ms;
  if (!impl::holdUntil_) impl::holdUntil_ = 1;   // never land on the "no hold" sentinel
  impl::evaluate();
}

// Walk a table so the display can be read against known raw values. raw = false steps
// TEMP_CURVE by temperature (calibration), raw = true steps RAW_SWEEP by duty (ripple check).
// dwellMs 0 takes the default. The dwell has to beat the clock's own update and averaging
// rate, which is unknown and evidently slower than 12 s, or a step is read mid-settle.
bool startMarch(bool raw, uint32_t dwellMs) {
  if (impl::marchRunning_) return false;
  if (!dwellMs) dwellMs = raw ? TEMP_SWEEP_STEP_MS : TEMP_MARCH_STEP_MS;
  impl::holdUntil_ = 0;
  impl::marchStep_ = 0;
  impl::marchRaw_ = raw;
  impl::marchDwell_ = dwellMs;
  impl::marchRunning_ = true;
  impl::marchNext_ = millis() + dwellMs;
  impl::evaluate();
  return true;
}

void loop() {
  const uint32_t now = millis();
  bool dirty = false;

  if (impl::marchRunning_ && (int32_t)(now - impl::marchNext_) >= 0) {
    if (++impl::marchStep_ >= impl::marchSteps()) {
      impl::marchRunning_ = false;
      impl::marchStep_ = 0;
    } else {
      impl::marchNext_ = now + impl::marchDwell_;
    }
    dirty = true;
  }

  if (impl::holdUntil_ && (int32_t)(now - impl::holdUntil_) >= 0) {
    impl::holdUntil_ = 0;
    dirty = true;
  }

#if TEMP_NEG_BLINK
  if (impl::negActive_ && (int32_t)(now - impl::negNext_) >= 0) {
    impl::negLow_ = !impl::negLow_;
    impl::negNext_ = now + (impl::negLow_ ? TEMP_NEG_LOW_MS : TEMP_NEG_HIGH_MS);
    dirty = true;
  }
#endif

  if (dirty) impl::evaluate();
}

}  // namespace tempout

// ---- Outdoor temperature feed: ECCC SWOB-ML -> tempout::setTargetC()
// Streams the response and scans for two quoted field names rather than buffering the
// document, so a malformed or oversized reply cannot grow the heap. See the WX_ config block.
namespace wx {

struct Status {
  bool     haveReading;        // a good reading has been applied at least once
  float    tempC;              // last accepted air_temp
  char     obsTime[28];        // date_tm as published, UTC
  bool     obsTimeValid;
  bool     ageKnown;           // false until the clock itself is NTP-synced
  uint32_t obsAgeS;            // age of the accepted reading at the moment it was accepted
  uint32_t attempts, accepted, httpFails, parseFails, staleRejects, heapSkips;
  int      lastHttpCode;
  char     lastError[56];
  uint32_t lastAttemptAgoS, lastOkAgoS;
  uint32_t nextInS;
  uint32_t heapBefore, heapAfter, largestBefore;
  bool     pending;            // a manual fetch is queued
};

namespace impl {

uint32_t nextMs_      = 0;
uint32_t lastAttempt_ = 0;
uint32_t lastOk_      = 0;
bool     everAttempt_ = false;
bool     everOk_      = false;
bool     pending_     = false;
bool     haveReading_ = false;
float    tempC_       = 0.0f;
char     obsTime_[28] = { 0 };
bool     obsValid_    = false;
bool     ageKnown_    = false;
uint32_t obsAgeS_     = 0;
uint32_t attempts_ = 0, accepted_ = 0, httpFails_ = 0, parseFails_ = 0;
uint32_t staleRejects_ = 0, heapSkips_ = 0;
int      lastCode_ = 0;
char     lastError_[56] = { 0 };
uint32_t heapBefore_ = 0, heapAfter_ = 0, largestBefore_ = 0;

void setError(const char* m) {
  std::strncpy(lastError_, m, sizeof lastError_ - 1);
  lastError_[sizeof lastError_ - 1] = '\0';
}

// Days since 1970-01-01 from a proleptic Gregorian date. Howard Hinnant's days_from_civil.
int64_t daysFromCivil(int y, unsigned m, unsigned d) {
  y -= m <= 2;
  const int era = (y >= 0 ? y : y - 399) / 400;
  const unsigned yoe = (unsigned)(y - era * 400);
  const unsigned doy = (153u * (m + (m > 2 ? -3u : 9u)) + 2u) / 5u + d - 1u;
  const unsigned doe = yoe * 365u + yoe / 4u - yoe / 100u + doy;
  return (int64_t)era * 146097 + (int64_t)doe - 719468;
}

// "2026-09-13T02:00:00.000Z" -> UTC epoch. Rejects anything that is not that exact shape,
// and rejects a non-Z suffix rather than silently treating a local time as UTC.
bool epochFromIso(const char* s, time_t* out) {
  if (std::strlen(s) < 20) return false;
  if (s[4] != '-' || s[7] != '-' || s[13] != ':' || s[16] != ':') return false;
  if (s[10] != 'T' && s[10] != ' ') return false;
  for (int i = 0; i < 19; ++i) {
    if (i == 4 || i == 7 || i == 10 || i == 13 || i == 16) continue;
    if (s[i] < '0' || s[i] > '9') return false;
  }
  if (!std::strchr(s + 19, 'Z')) return false;
  const int Y  = (s[0]-'0')*1000 + (s[1]-'0')*100 + (s[2]-'0')*10 + (s[3]-'0');
  const int Mo = (s[5]-'0')*10 + (s[6]-'0');
  const int D  = (s[8]-'0')*10 + (s[9]-'0');
  const int H  = (s[11]-'0')*10 + (s[12]-'0');
  const int Mi = (s[14]-'0')*10 + (s[15]-'0');
  const int Se = (s[17]-'0')*10 + (s[18]-'0');
  if (Y < 2020 || Y > 2199 || Mo < 1 || Mo > 12 || D < 1 || D > 31) return false;
  if (H > 23 || Mi > 59 || Se > 60) return false;
  *out = (time_t)(daysFromCivil(Y, (unsigned)Mo, (unsigned)D) * 86400LL
                  + (int64_t)H * 3600 + (int64_t)Mi * 60 + Se);
  return true;
}

// Finds name="<needle>" ... value="<v>" in a byte stream, one character at a time.
// The needle carries its own quotes so that "air_temp" cannot match avg_air_temp_pst1hr.
class FieldScan {
 public:
  explicit FieldScan(const char* needle) : needle_(needle) {}

  void feed(char c) {
    if (done_) return;
    if (state_ == 0) {
      np_ = (c == needle_[np_]) ? (uint8_t)(np_ + 1) : (uint8_t)(c == needle_[0] ? 1 : 0);
      if (needle_[np_] == '\0') { state_ = 1; tp_ = 0; }
      return;
    }
    if (state_ == 1) {
      tp_ = (c == TAG[tp_]) ? (uint8_t)(tp_ + 1) : (uint8_t)(c == TAG[0] ? 1 : 0);
      if (TAG[tp_] == '\0') { state_ = 2; len_ = 0; }
      return;
    }
    if (c == '"') { buf_[len_] = '\0'; done_ = true; return; }
    if (len_ < sizeof buf_ - 1) buf_[len_++] = c;
    else { buf_[len_] = '\0'; done_ = true; }      // value absurdly long: take what we have
  }

  bool        done()  const { return done_; }
  const char* value() const { return buf_; }

 private:
  static constexpr const char* TAG = " value=\"";
  const char* needle_;
  uint8_t np_ = 0, tp_ = 0, state_ = 0, len_ = 0;
  char buf_[28] = { 0 };
  bool done_ = false;
};

bool accept(const FieldScan& fsTemp, const FieldScan& fsTime);

// Set when a fetch saw a 404 and a suffix probe is worth running once the session is closed.
bool wantProbe_ = false;
// One probe per station per suffix. Without this, a host answering HEAD 200 while answering
// GET 404 would flip the cached suffix back and forth at network round-trip rate, with a full
// settings write per cycle.
bool probeExhausted_ = false;

// Build the observation URL. A station containing '-' is already a complete stem (CYYZ-MAN)
// and gets only the extension; a bare code gets the suffix it is given.
void buildUrl(char* out, size_t n, const char* suffix) {
  if (settings::wxStationIsStem(g_settings.wxStation))
    std::snprintf(out, n, "%s://%s%s%s-swob.xml", WX_USE_HTTPS ? "https" : "http",
                  WX_HOST, WX_PATH_PREFIX, g_settings.wxStation);
  else
    std::snprintf(out, n, "%s://%s%s%s%s", WX_USE_HTTPS ? "https" : "http",
                  WX_HOST, WX_PATH_PREFIX, g_settings.wxStation, suffix);
}

// HEAD one URL and return the status code, or a negative HTTPClient error. Only used to find
// which suffix a bare code lives under, so the body is never wanted. Verified against the live
// host: it answers HEAD with the same 200 or 404 it answers a GET with.
int headCode(const char* url) {
#if WX_USE_HTTPS
  WiFiClientSecure client;
  client.setInsecure();
#else
  WiFiClient client;
#endif
  HTTPClient http;
  http.setConnectTimeout(WX_PROBE_TIMEOUT_MS);
  http.setTimeout(WX_PROBE_TIMEOUT_MS);
  http.setReuse(false);
  http.setFollowRedirects(HTTPC_DISABLE_FOLLOW_REDIRECTS);
  if (!http.begin(client, url)) return -1;
  const int code = http.sendRequest("HEAD");
  http.end();
  return code;
}
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
void loop() {
  wifimgr::loop();

  if (wifimgr::takeGotIp()) {
    // Re-anchor on the primary: a reconnect is a new network situation, and whatever drove
    // the device onto a fallback may well have been the link itself.
    timekeeping::selectSlot(0);             // immediate NTP request on every (re)connect
    if (!g_mdnsStarted && MDNS.begin(DEVICE_HOSTNAME)) {
      MDNS.addService("http", "tcp", 80);
      g_mdnsStarted = true;
    }
    Serial.printf("Wi-Fi up: http://%s/  (http://%s.local/)\n",
                  WiFi.localIP().toString().c_str(), DEVICE_HOSTNAME);
  }

  ntpPolicy();
  webui::loop();
  tempout::loop();
  wx::loop();
  diag::loop();

  // Heartbeat: a repeating startup banner with "up" resetting means the ESP32 is rebooting;
  // "served" stuck at 0 while the web page is open means the status handler is faulting.
  static uint32_t hbMs = 0;
  if (millis() - hbMs >= 5000) {
    hbMs = millis();
    // largest = biggest contiguous block. Fragmentation shows here while "heap" stays flat.
    Serial.printf("[hb] up %lus heap %u largest %u min %u wifi %s served %lu\n",
                  (unsigned long)(millis() / 1000), (unsigned)ESP.getFreeHeap(),
                  (unsigned)heap_caps_get_largest_free_block(MALLOC_CAP_8BIT),
                  (unsigned)ESP.getMinFreeHeap(),
                  WiFi.isConnected() ? "up" : "down", (unsigned long)webui::statusServed());
  }
  delay(2);
}
