AndrewFrelas/DS1302-Based-Chinese-4-in-1-Clock-Mod-ESP32-C3-Super-Mini-NTP-Time-Sync-Canada-Based/(commit log)

2026-09-15 Create NtpClockMod_v01_03_08.ino
    Current Firmware
2026-09-15 Update README.md
    fix readme bom
2026-09-15 Update README.md
    Fixing Readme for proper and clearer instructions on Bill of Materials and wire
2026-09-15 Update README.md
    where to mount the esp32
2026-09-16 Update and rename NtpClockMod_v01_03_08.ino to NtpClockMod.ino
    New Version stability of clock emulation fixes and temp fixes
    [NtpClockMod.ino]
2026-09-16 Update NtpClockMod.ino
    fixing timing for min flip over
    [NtpClockMod.ino]
